riversnails/narsha_database/study/arm/MangoM32F2-Manual-Source/Mango-M32F2-프리미엄패키지1.jpg

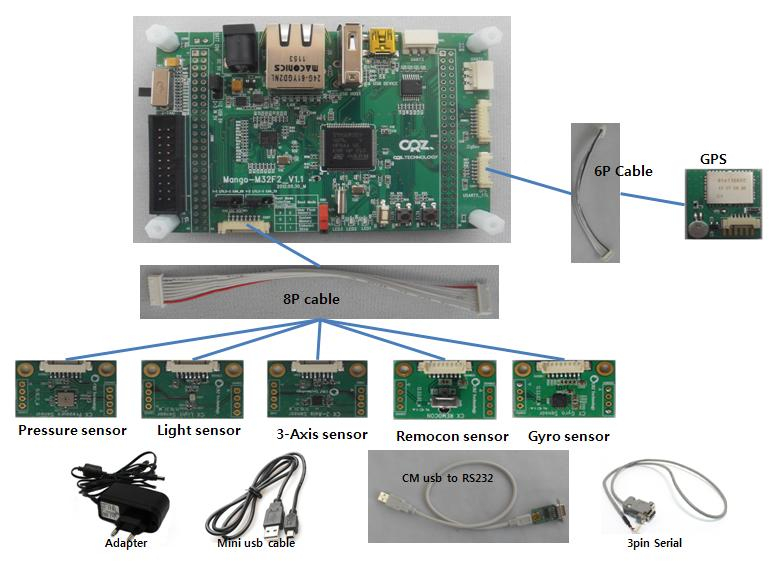
study/arm/MangoM32F2-Manual-Source/Mango-M32F2-프리미엄패키지1.jpg
