riversnails/narsha_database/readme.md

나르샤 저장용도의 리포지토리 입니다.
====================================
대구소프트웨어고등학교의 수업, 나르샤등의 자료를 저장하는 용도입니다.
