riversnails/narsha_database/study/arm/lecture/TIMER_PWM/LED_Servo_PWM.txt

[서보모터]
주기 : 20 ms
단계 : 2000 단계 

==> PSC : 720 -> 100 KHz
==> ARR : 2000 -> 20 ms

duty : 0.7 ~ 2.3 ms ==>  70 ~ 230 -> 160 단계
==> ARR : 70 ~ 230

[LED PWM]

주기 : 2 ms
단계 : 200 단계

==> PSC : 720 -> 100 KHz
==> ARR : 200 -> 2 ms
