riversnails/narsha_database/datasheet/1200px-Arduinomega1-4connectors.png

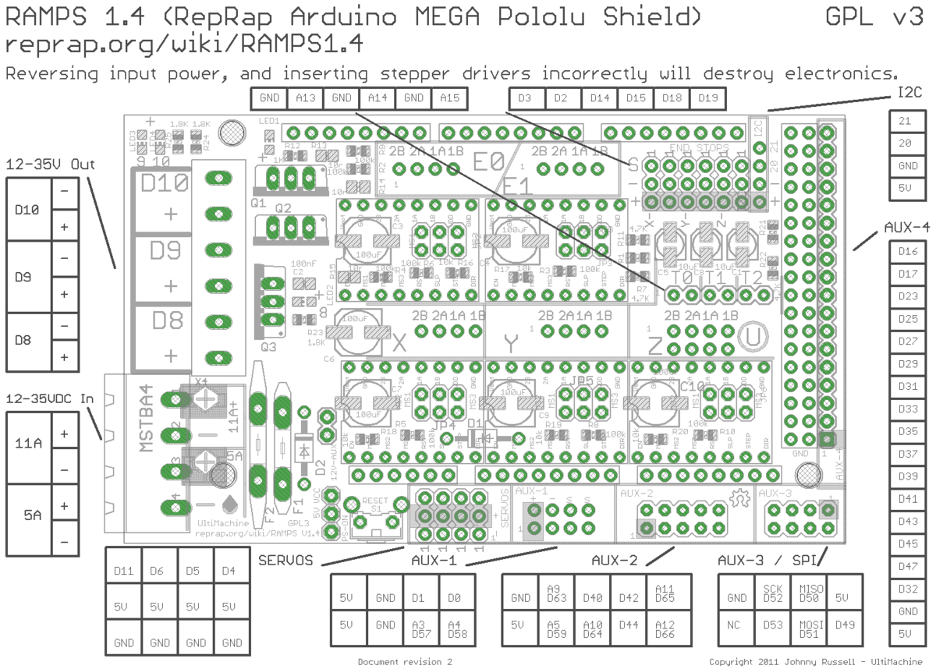
datasheet/1200px-Arduinomega1-4connectors.png
