riversnails/narsha_database/datasheet/1200px-Ramps_v1.4_shield_bothsides.png

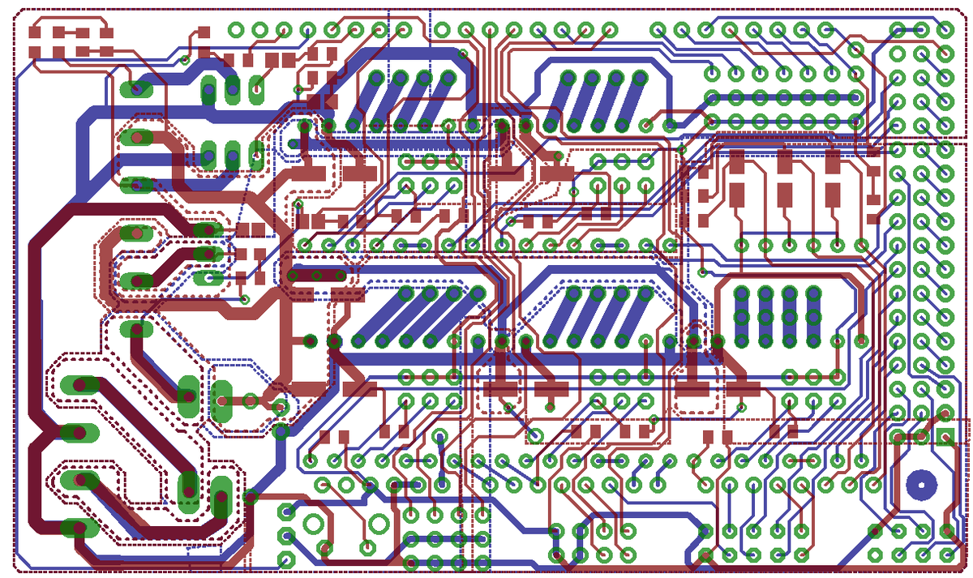
datasheet/1200px-Ramps_v1.4_shield_bothsides.png
