riversnails/narsha_database/datasheet/char_LCD_datasheet.png

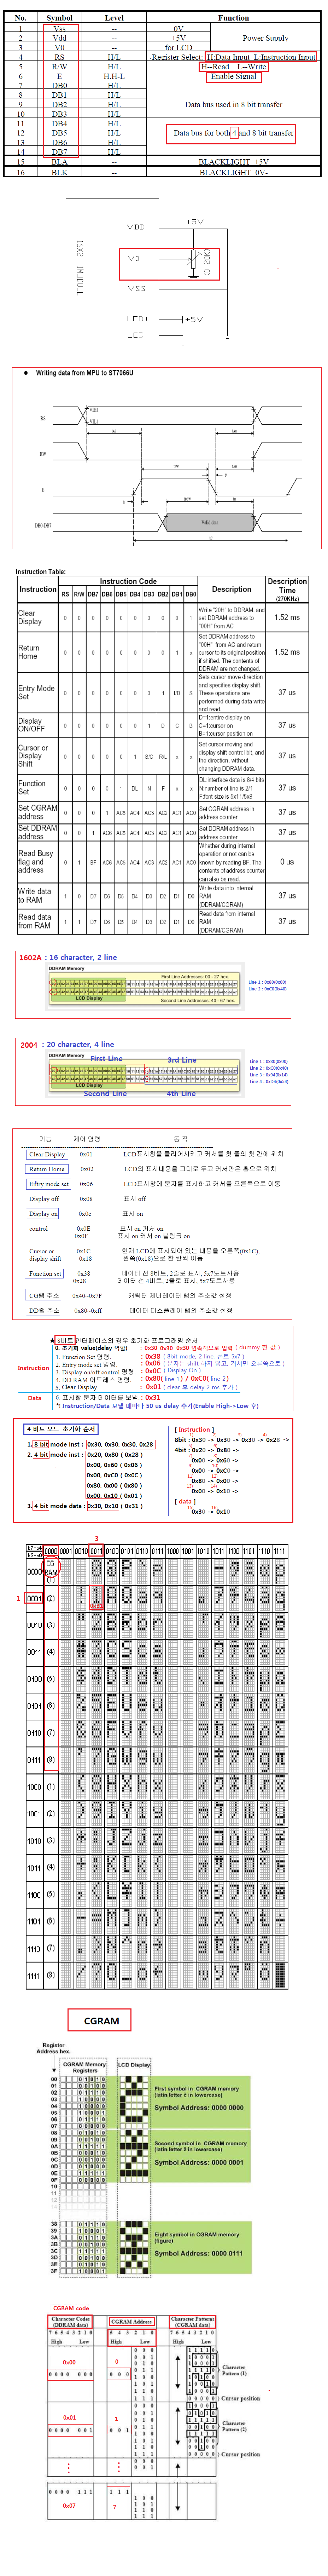
datasheet/char_LCD_datasheet.png
