riversnails/narsha_database/datasheet/dot matrix_datasheet.jpg

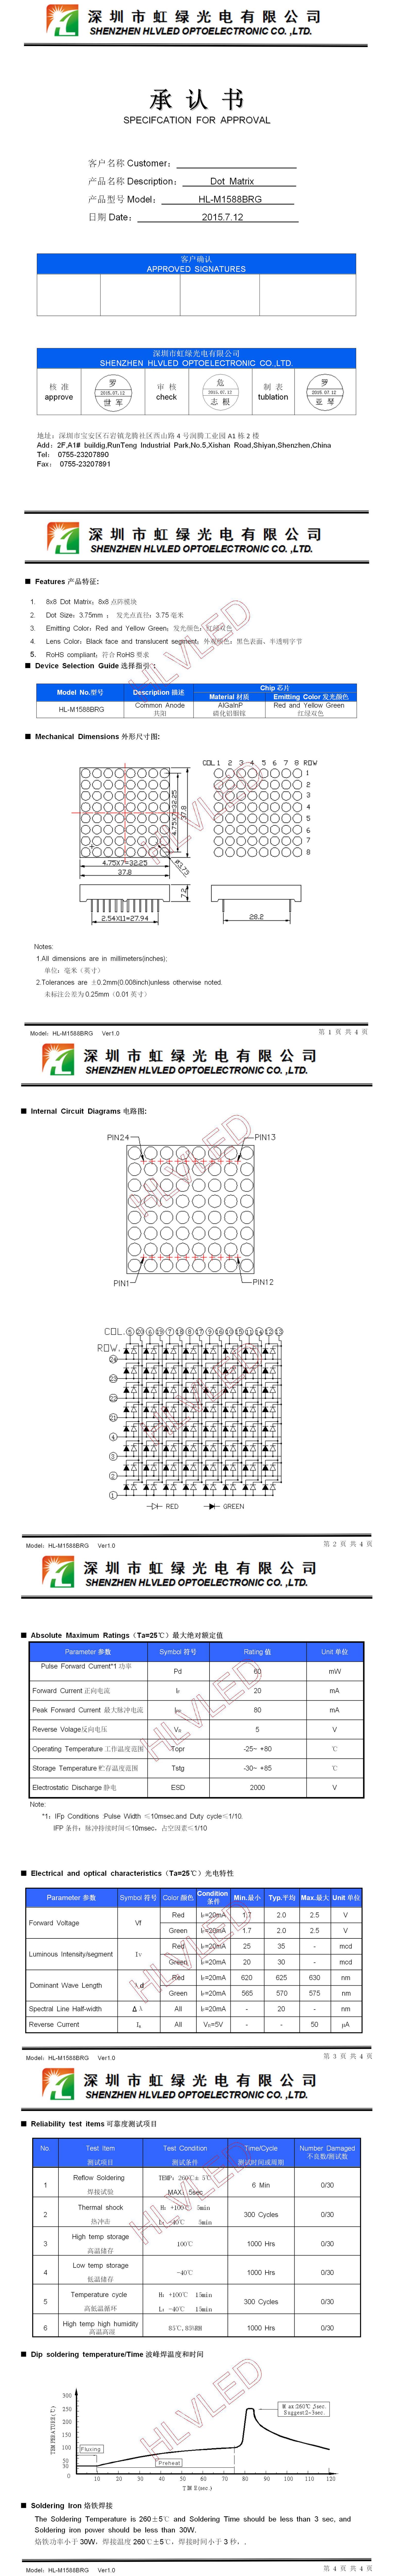
datasheet/dot matrix_datasheet.jpg
