riversnails/narsha_database/datasheet/nucleo_103RB/nucleo-103RB_pinMap.jpg

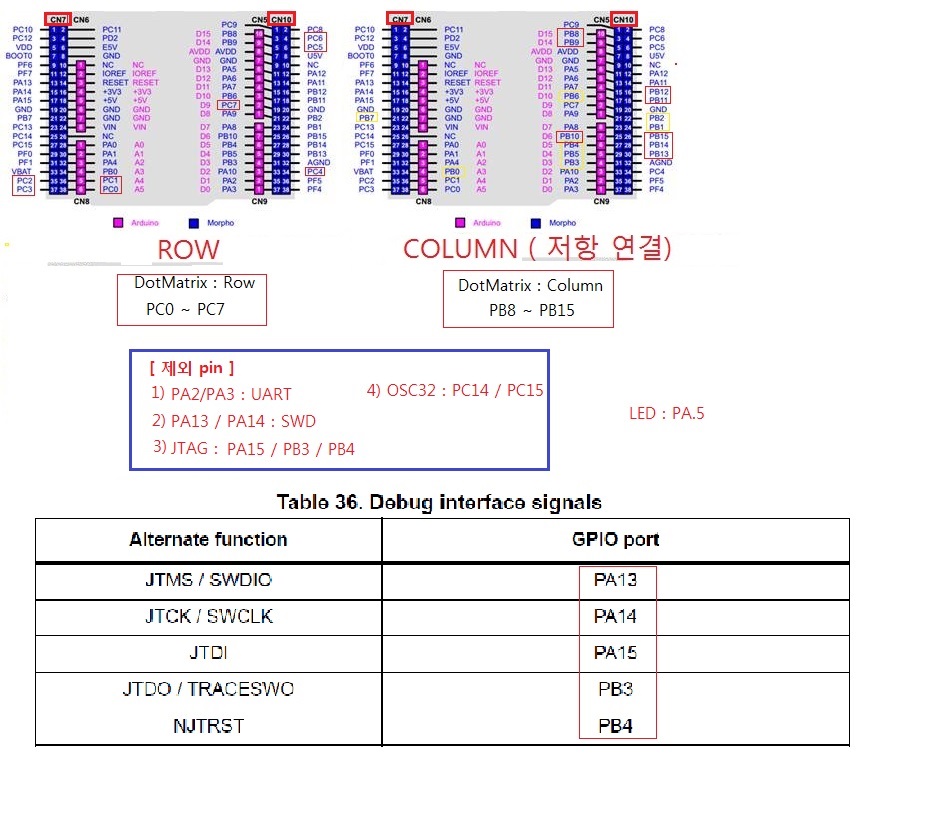
datasheet/nucleo_103RB/nucleo-103RB_pinMap.jpg
