riversnails/narsha_database/study/arm/GPIO/GPIO.png

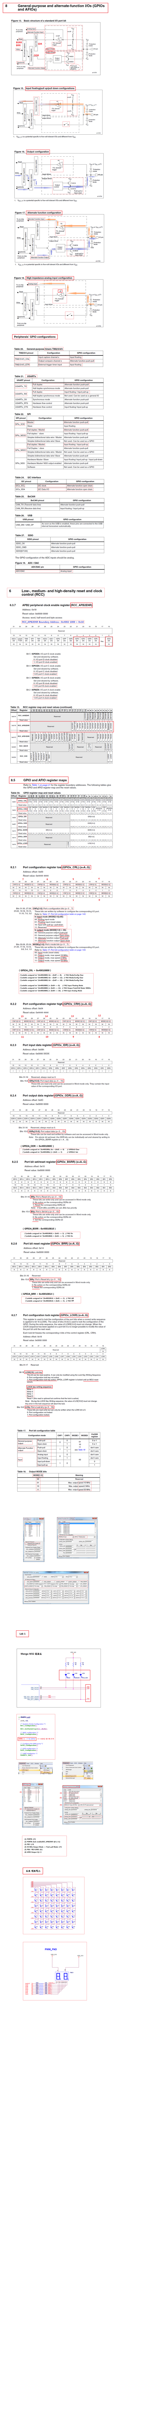
study/arm/GPIO/GPIO.png
