riversnails/narsha_database/study/arm/GPIO/도트매트릭스.png

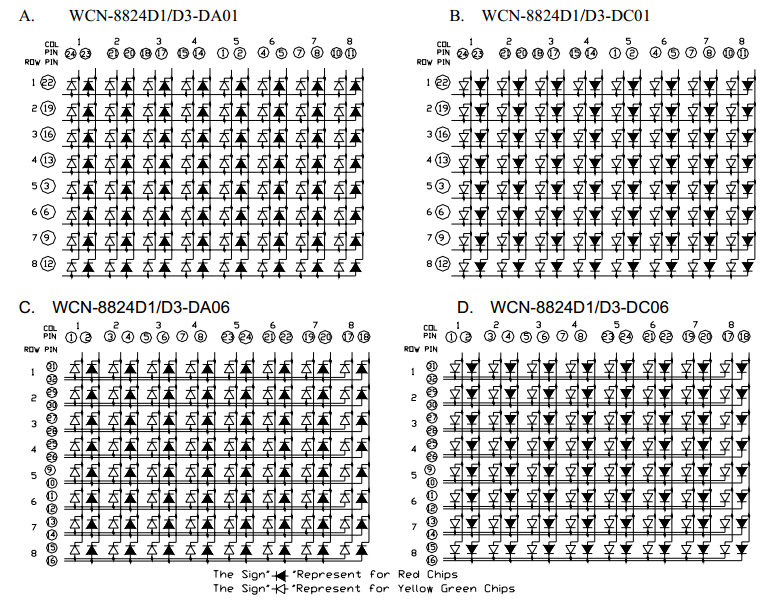
study/arm/GPIO/도트매트릭스.png
