riversnails/narsha_database/study/arm/lecture/ADC/ADC.png

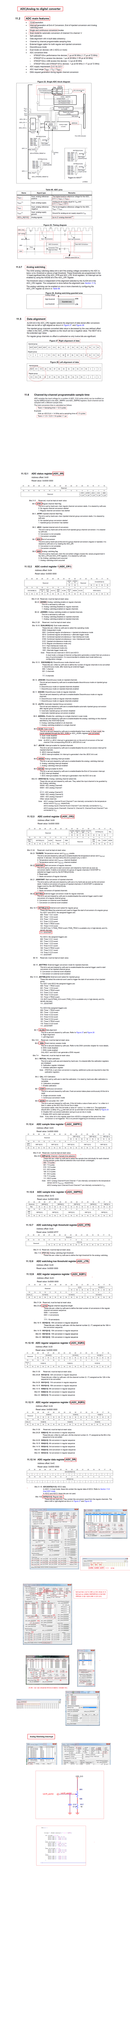
study/arm/lecture/ADC/ADC.png
