riversnails/narsha_database/study/arm/lecture/DMA/DMA.png

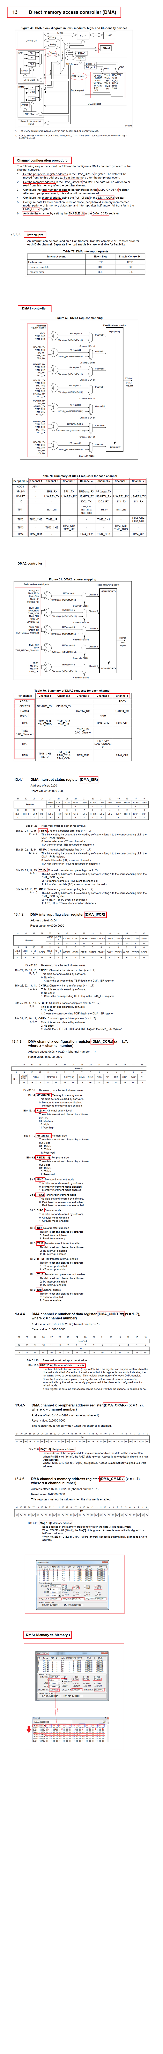
study/arm/lecture/DMA/DMA.png
