riversnails/narsha_database/study/arm/lecture/DMA/시험문제1.png

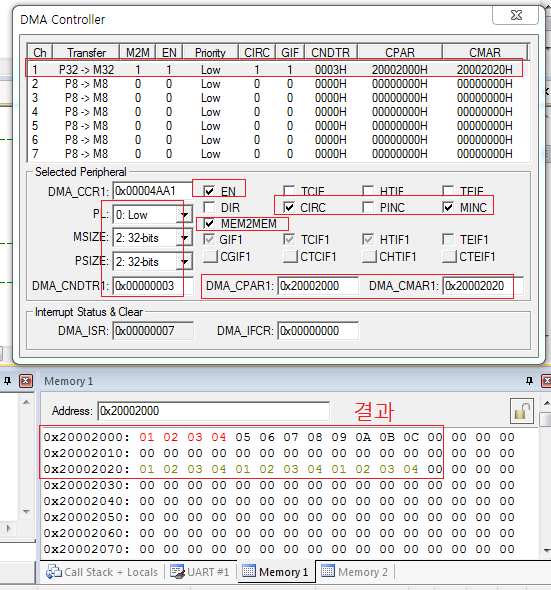
study/arm/lecture/DMA/시험문제1.png
