riversnails/narsha_database/study/arm/lecture/EXTI/4x4keypad.png

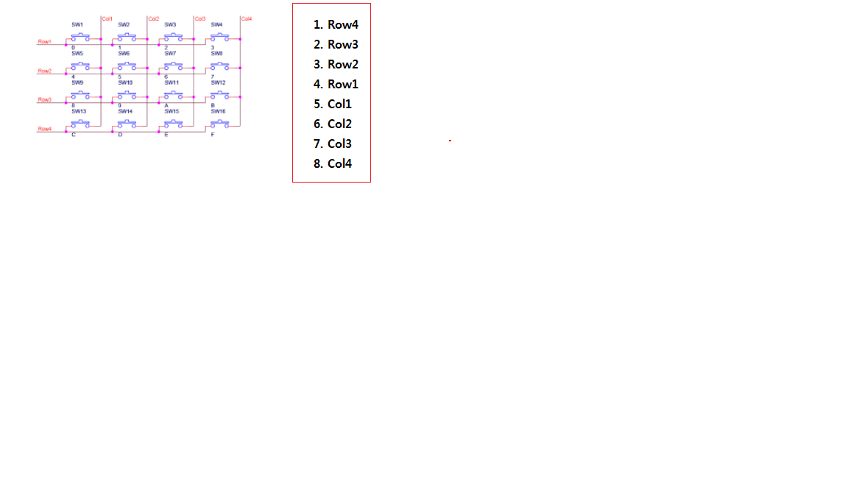
study/arm/lecture/EXTI/4x4keypad.png
