riversnails/narsha_database/study/arm/lecture/EXTI/EXTI.png

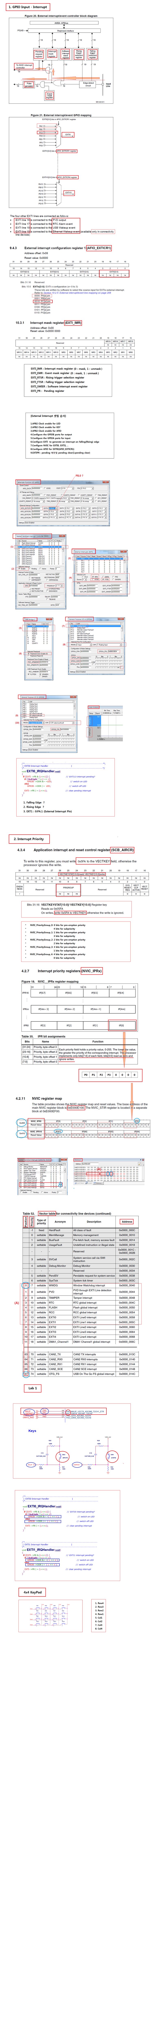
study/arm/lecture/EXTI/EXTI.png
