riversnails/narsha_database/study/arm/lecture/I2C/EEPROM_Read_Write.png

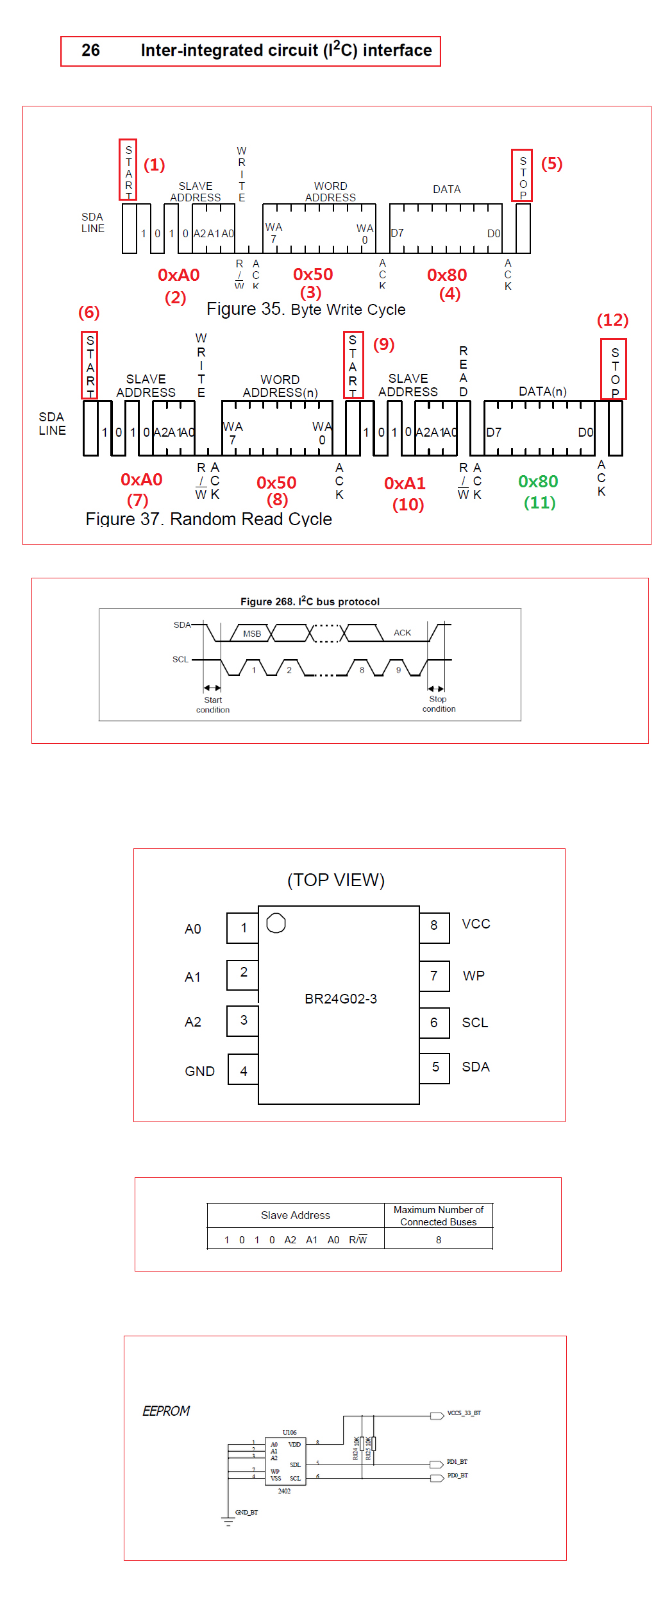
study/arm/lecture/I2C/EEPROM_Read_Write.png
