riversnails/narsha_database/study/arm/lecture/I2C/I2C.png

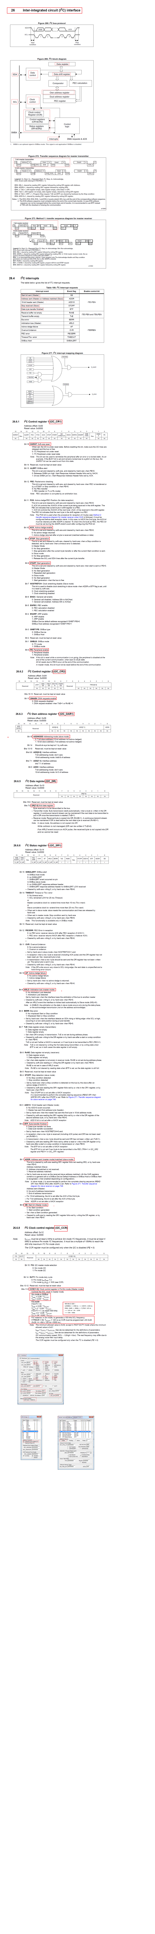
study/arm/lecture/I2C/I2C.png
