riversnails/narsha_database/study/arm/lecture/IWDG/IWDG.png

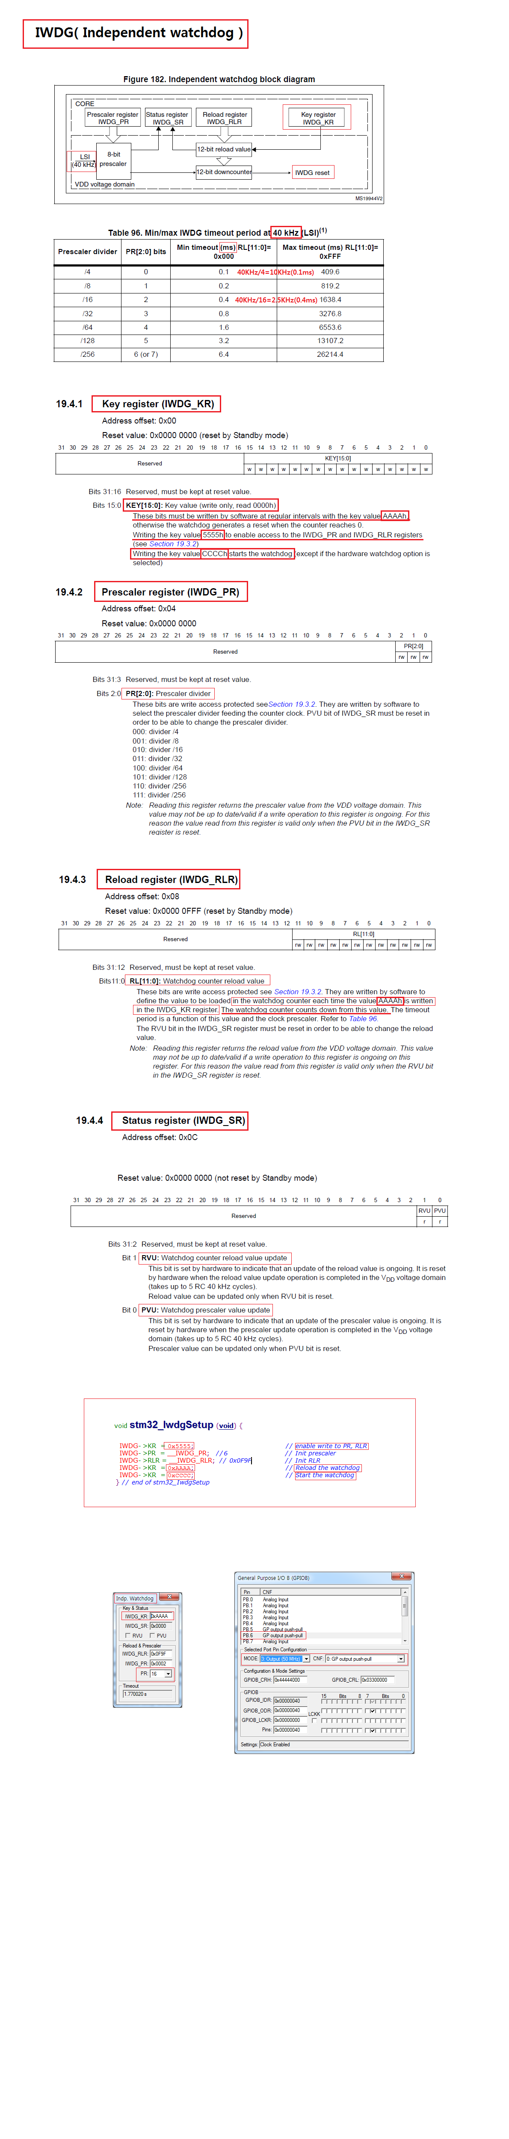
study/arm/lecture/IWDG/IWDG.png
