riversnails/narsha_database/study/arm/lecture/JTAG/jtag_pin.png

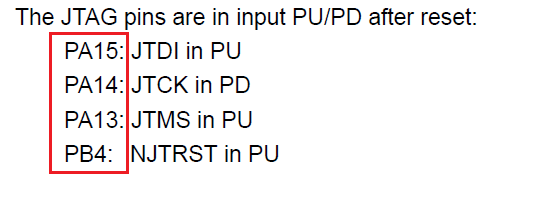
study/arm/lecture/JTAG/jtag_pin.png
