riversnails/narsha_database/study/arm/lecture/Keil_tool/keil_lib.png

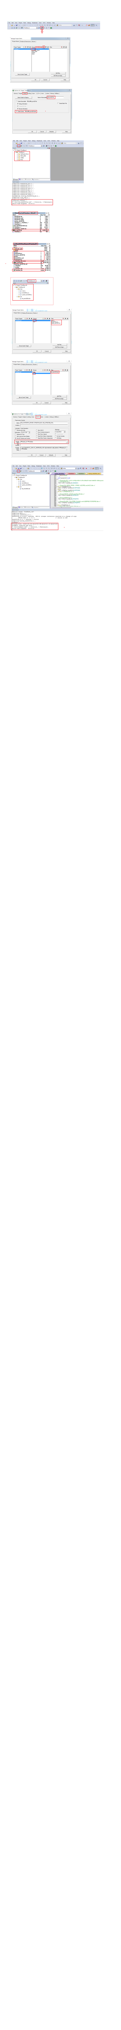
study/arm/lecture/Keil_tool/keil_lib.png
