riversnails/narsha_database/study/arm/lecture/Keil_tool/keil_new_project.png

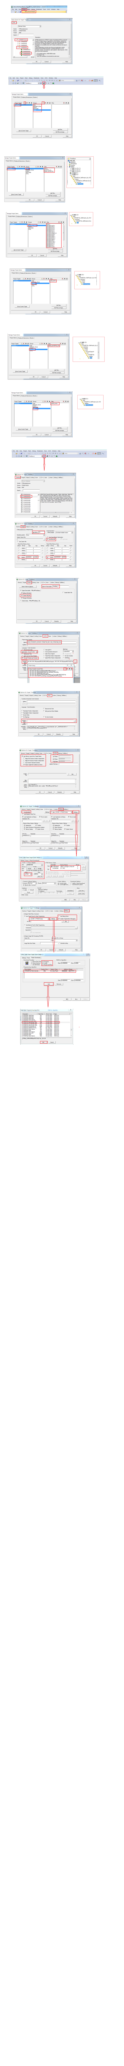
study/arm/lecture/Keil_tool/keil_new_project.png
