riversnails/narsha_database/study/arm/lecture/SPI/SPI.png

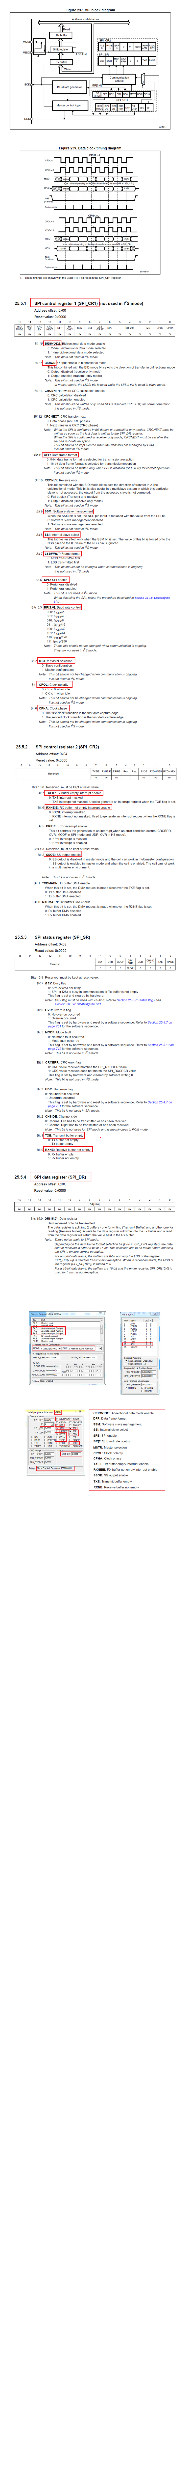
study/arm/lecture/SPI/SPI.png
