riversnails/narsha_database/study/arm/lecture/STM32_CortexM3/STM32_CortexM3.png

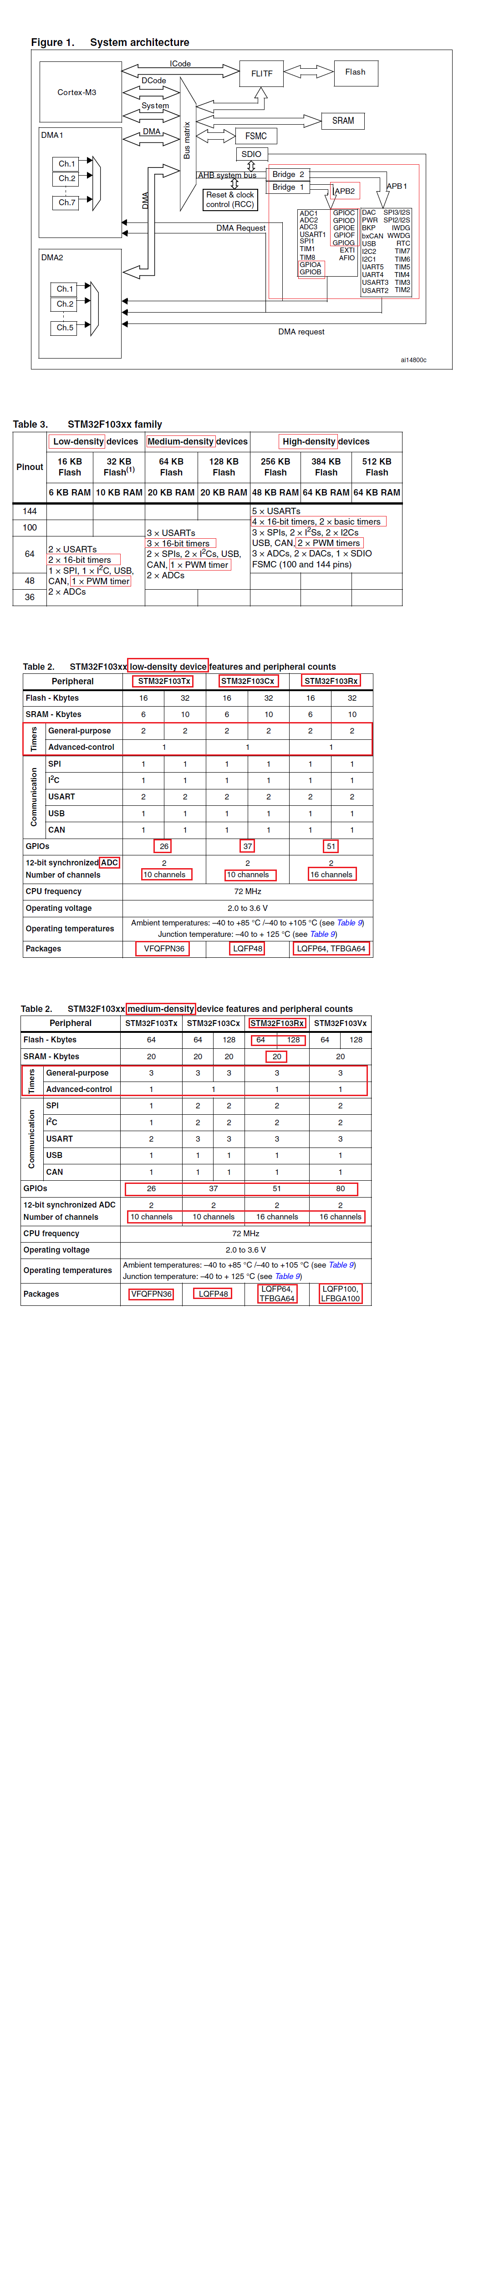
study/arm/lecture/STM32_CortexM3/STM32_CortexM3.png
