riversnails/narsha_database/study/arm/lecture/SYSTICk/SysTick.png

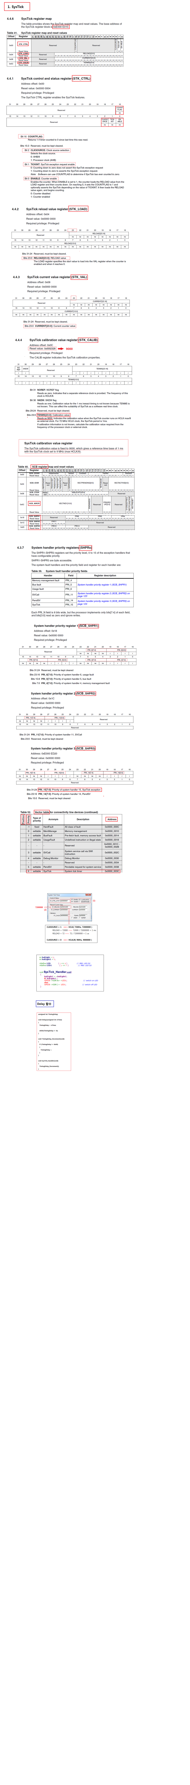
study/arm/lecture/SYSTICk/SysTick.png
