riversnails/narsha_database/study/arm/lecture/tft_lcd/LGDP4532.png

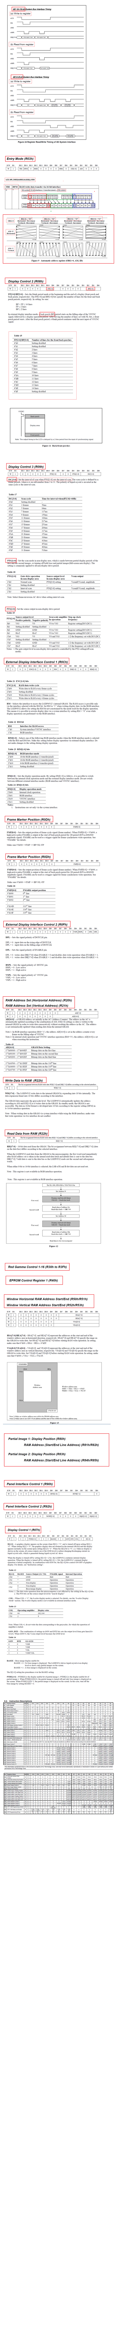
study/arm/lecture/tft_lcd/LGDP4532.png
