riversnails/narsha_database/study/arm/lecture/TIMER_PWM/TIMER_PWM.png

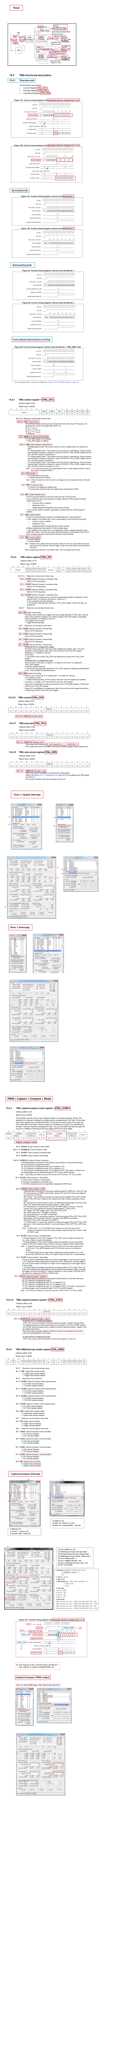
study/arm/lecture/TIMER_PWM/TIMER_PWM.png
