riversnails/narsha_database/study/arm/lecture/UART/CTS_RTS.png

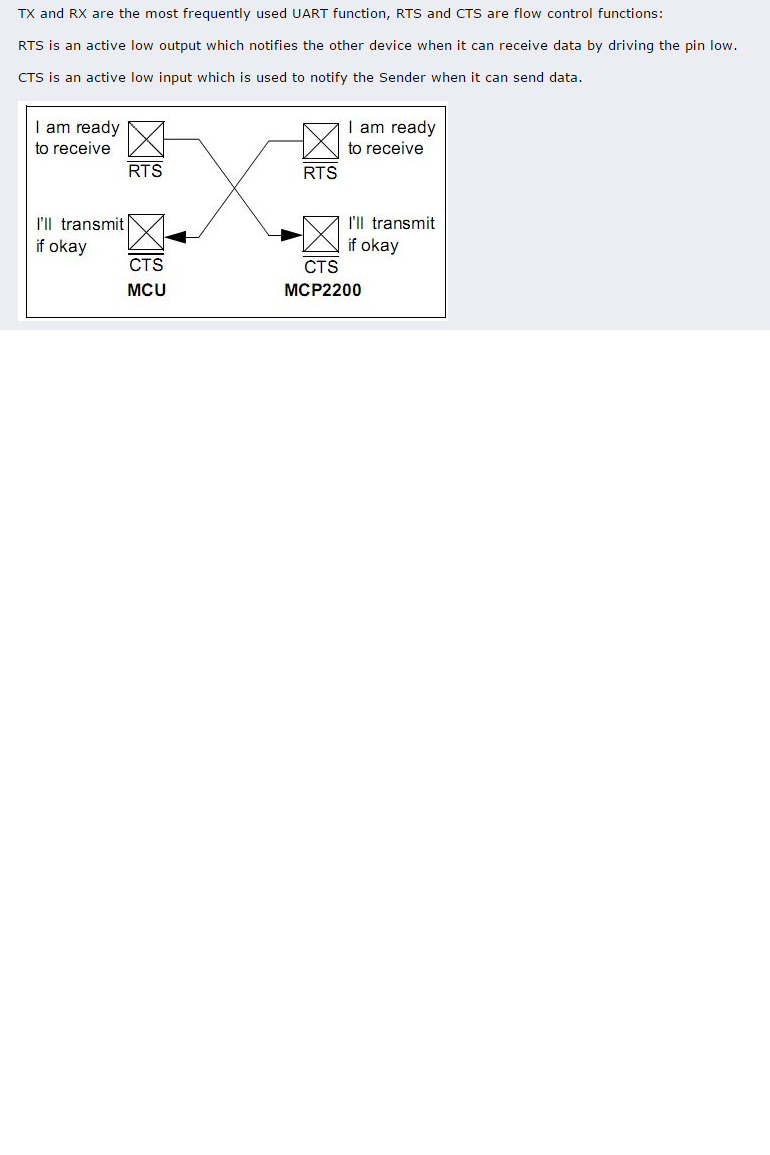
study/arm/lecture/UART/CTS_RTS.png
