riversnails/narsha_database/study/arm/lecture/UART/UART.png

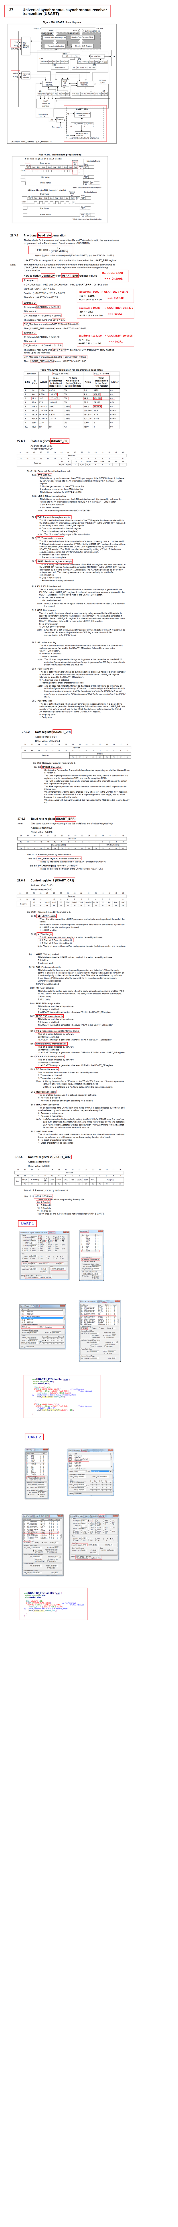
study/arm/lecture/UART/UART.png
