riversnails/narsha_database/study/avr/arduino/control2/main.png

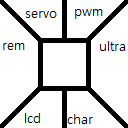
study/avr/arduino/control2/main.png
