riversnails/narsha_database/study/avr/arduino/control/main.bmp

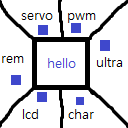
study/avr/arduino/control/main.bmp
