riversnails/narsha_database/study/avr/arduino/oled_128_128/tiger_128_128_24bit.bmp

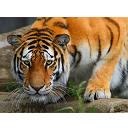
study/avr/arduino/oled_128_128/tiger_128_128_24bit.bmp
