riversnails/narsha_database/study/pads/uno headersize_2.png

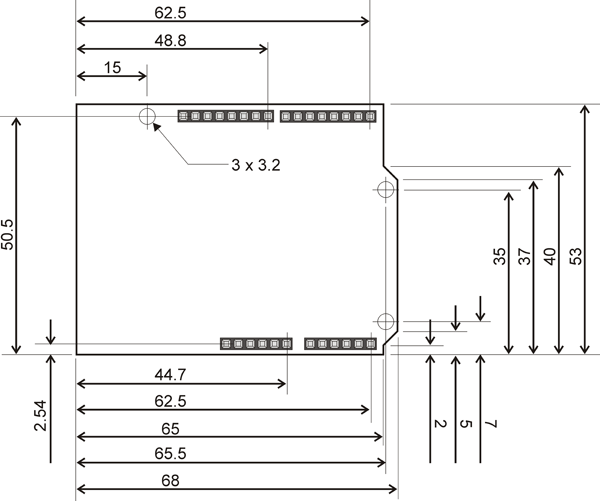
study/pads/uno headersize_2.png
