riversnails/narsha_database/study/tetris/background1.jpg

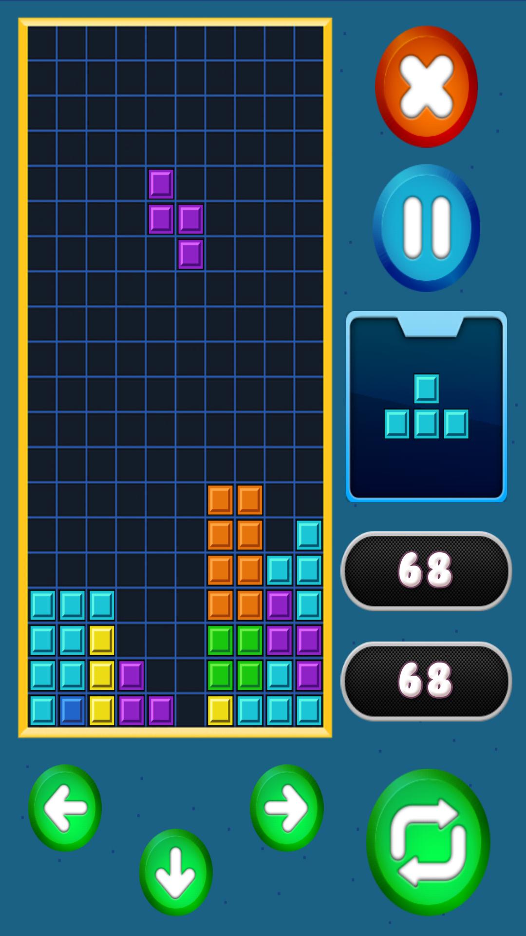
study/tetris/background1.jpg
