riversnails/narsha_database/study/tetris/background.jpg

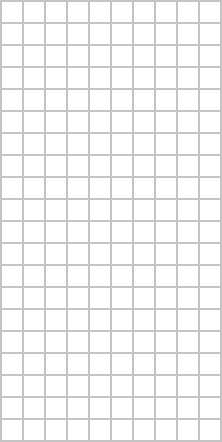
study/tetris/background.jpg
