riversnails/narsha_database/나르샤/tetris_re/tetris_re/Resources/tetris_background.png

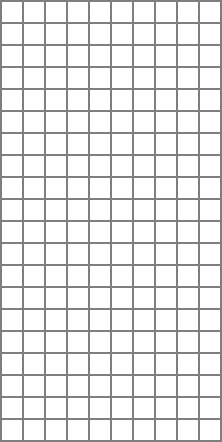
나르샤/tetris_re/tetris_re/Resources/tetris_background.png
