riversnails/narsha_database/study/arm/MangoM32F2-Manual-Source/Source/mango-m32f2_120612_1731_usbdev-vcp/src/readme.txt

/**
  @page USART_Printf USART_Printf
  
  @verbatim
  ******************** (C) COPYRIGHT 2011 STMicroelectronics *******************
  * @file    USART/USART_Printf/readme.txt 
  * @author  MCD Application Team
  * @version V1.0.0
  * @date    18-April-2011
  * @brief   Description of the USART Printf Example.
  ******************************************************************************
  * THE PRESENT FIRMWARE WHICH IS FOR GUIDANCE ONLY AIMS AT PROVIDING CUSTOMERS
  * WITH CODING INFORMATION REGARDING THEIR PRODUCTS IN ORDER FOR THEM TO SAVE
  * TIME. AS A RESULT, STMICROELECTRONICS SHALL NOT BE HELD LIABLE FOR ANY
  * DIRECT, INDIRECT OR CONSEQUENTIAL DAMAGES WITH RESPECT TO ANY CLAIMS ARISING
  * FROM THE CONTENT OF SUCH FIRMWARE AND/OR THE USE MADE BY CUSTOMERS OF THE
  * CODING INFORMATION CONTAINED HEREIN IN CONNECTION WITH THEIR PRODUCTS.
  ******************************************************************************
   @endverbatim

@par Example Description 

This example shows how to retarget the C library printf function to the USART. 
This implementation output the printf message on the Hyperterminal using USART3.

The USARTx is configured as follow:
    - BaudRate = 115200 baud  
    - Word Length = 8 Bits
    - One Stop Bit
    - No parity
    - Hardware flow control disabled (RTS and CTS signals)
    - Receive and transmit enabled

@par Directory contents 

  - USART/USART_Printf/system_stm32f2xx.c   STM32F2xx system clock configuration file
  - USART/USART_Printf/stm32f2xx_conf.h     Library Configuration file
  - USART/USART_Printf/stm32f2xx_it.h       Interrupt handlers header file
  - USART/USART_Printf/stm32f2xx_it.c       Interrupt handlers
  - USART/USART_Printf/main.c               Main program

@note The "system_stm32f2xx.c" is generated by an automatic clock configuration 
      tool and can be easily customized to your own configuration. 
      To select different clock setup, use the "STM32F2xx_Clock_Configuration_V1.0.0.xls" tool. 

@par Hardware and Software environment 

  - This example runs on STM32F2xx Devices.
  
  - This example has been tested with STM322xG-EVAL RevB and can be easily tailored
    to any other development board.

  - STM322xG-EVAL Set-up 
    - Connect a null-modem female/female RS232 cable between the DB9 connector 
      CN16 (USART3) and PC serial port if you want to display data on the HyperTerminal.
      @note Make sure that jumper JP22 is in position 1-2
 
  - Hyperterminal configuration:
    - Word Length = 8 Bits
    - One Stop Bit
    - No parity
    - BaudRate = 115200 baud
    - flow control: None 

@par How to use it ? 

In order to make the program work, you must do the following :
 - Copy all source files from this example folder to the template folder under
   Project\STM32F2xx_StdPeriph_Template
 - Open your preferred toolchain 
 - Rebuild all files and load your image into target memory
 - Run the example
  
 * <h3><center>&copy; COPYRIGHT 2011 STMicroelectronics</center></h3>
 */
