riversnails/narsha_database/study/arm/MangoM32F2-Manual-Source/Source/mango-m32f2_120612_1731_usbdev-vcp/project/EWARM-Standalone-httpserver/readme.txt

/**
  @page ewarm EWARM Project Template for STM32F2xx devices
  
  @verbatim
  ******************* (C) COPYRIGHT 2011 STMicroelectronics ********************
  * @file    readme.txt
  * @author  MCD Application Team
  * @version V1.0.0
  * @date    18-April-2011
  * @brief   This sub-directory contains all the user-modifiable files needed to
  *          create a new project linked with the STM32F2xx Standard Peripherals 
  *          Library and working with IAR Embedded Workbench for ARM (EWARM)
  *          software toolchain (version 6.10.5 and later).
  ******************************************************************************
  * THE PRESENT FIRMWARE WHICH IS FOR GUIDANCE ONLY AIMS AT PROVIDING CUSTOMERS
  * WITH CODING INFORMATION REGARDING THEIR PRODUCTS IN ORDER FOR THEM TO SAVE
  * TIME. AS A RESULT, STMICROELECTRONICS SHALL NOT BE HELD LIABLE FOR ANY
  * DIRECT, INDIRECT OR CONSEQUENTIAL DAMAGES WITH RESPECT TO ANY CLAIMS ARISING
  * FROM THE CONTENT OF SUCH FIRMWARE AND/OR THE USE MADE BY CUSTOMERS OF THE
  * CODING INFORMATION CONTAINED HEREIN IN CONNECTION WITH THEIR PRODUCTS.
  ******************************************************************************
  @endverbatim
 
 @par Directory contents

 - project .ewd/.eww/.ewp: A pre-configured project file with the provided library 
                           structure that produces an executable image with IAR 
                           Embedded Workbench.
                
 - stm32f2xx_flash.icf : This file is the IAR Linker configuration file used to 
                         place program code (readonly) in internal FLASH and data
                         (readwrite, Stack and Heap)in internal SRAM. 
                         You can customize this file to your need.                                                                                

 - stm32f2xx_flash_extsram.icf: This file is the IAR Linker configuration file 
                                used to place program code (readonly) in internal 
                                FLASH and data (readwrite, Stack and Heap)in 
                                external SRAM. You can customize this file to your need.  
                                
 - stm32f2xx_ram.icf:  This file is the IAR Linker configuration file used to 
                       place program code (readonly) and data (readwrite, Stack 
                       and Heap)in internal SRAM. 
                       You can customize this file to your need.                    
                             
 @par How to use it ?

 - Open the Project.eww workspace.
 - Rebuild all files: Project->Rebuild all
 - Load project image: Project->Download and Debug
 - Run program: Debug->Go(F5)

 @note The needed define symbols for this config are already declared in the
       preprocessor section: USE_STM322xG_EVAL, STM32F2XX, USE_STDPERIPH_DRIVER 

 * <h3><center>&copy; COPYRIGHT 2011 STMicroelectronics</center></h3>
 */
