riversnails/narsha_database/study/arm/STM32F2xx_StdPeriph_Lib_V1.1.0/Project/STM32F2xx_StdPeriph_Examples/TIM/6Steps/readme.txt

/**
  @page TIM_6Steps TIM 6 Steps example
  
  @verbatim
  ******************** (C) COPYRIGHT 2012 STMicroelectronics *******************
  * @file    TIM/6Steps/readme.txt 
  * @author  MCD Application Team
  * @version V1.1.0
  * @date    13-April-2012
  * @brief   Description of the TIM 6 Steps example.
  ******************************************************************************
  *
  * Licensed under MCD-ST Liberty SW License Agreement V2, (the "License");
  * You may not use this file except in compliance with the License.
  * You may obtain a copy of the License at:
  *
  *        http://www.st.com/software_license_agreement_liberty_v2
  *
  * Unless required by applicable law or agreed to in writing, software 
  * distributed under the License is distributed on an "AS IS" BASIS, 
  * WITHOUT WARRANTIES OR CONDITIONS OF ANY KIND, either express or implied.
  * See the License for the specific language governing permissions and
  * limitations under the License.
  *
  ******************************************************************************
   @endverbatim

@par Example Description 

This example shows how to configure the TIM1 peripheral to generate 6 Steps.
The STM32F2xx TIM1 peripheral offers the possibility to program in advance the 
configuration for the next TIM1 outputs behaviour (step) and change the configuration
of all the channels at the same time. This operation is possible when the COM 
(commutation) event is used.
The COM event can be generated by software by setting the COM bit in the TIM1_EGR
register or by hardware (on TRC rising edge).
In this example, a software COM event is generated each 100 ms: using the SysTick 
interrupt.
The TIM1 is configured in Timing Mode, each time a COM event occurs, a new TIM1
configuration will be set in advance.

The break Polarity is used at High level.

The following Table describes the TIM1 Channels states:
 @verbatim
              -----------------------------------------------
             | Step1 | Step2 | Step3 | Step4 | Step5 | Step6 |
   ----------------------------------------------------------
  |Channel1  |   1   |   0   |   0   |   0   |   0   |   1   |
   ----------------------------------------------------------
  |Channel1N |   0   |   0   |   1   |   1   |   0   |   0   |
   ----------------------------------------------------------
  |Channel2  |   0   |   0   |   0   |   1   |   1   |   0   |
   ----------------------------------------------------------
  |Channel2N |   1   |   1   |   0   |   0   |   0   |   0   |
   ----------------------------------------------------------
  |Channel3  |   0   |   1   |   1   |   0   |   0   |   0   |
   ----------------------------------------------------------
  |Channel3N |   0   |   0   |   0   |   0   |   1   |   1   |
   ----------------------------------------------------------
 @endverbatim

@par Directory contents 

  - TIM/6Steps/stm32f2xx_conf.h    Library Configuration file
  - TIM/6Steps/stm32f2xx_it.c      Interrupt handlers
  - TIM/6Steps/stm32f2xx_it.h      Interrupt handlers header file
  - TIM/6Steps/main.c              Main program
  - TIM/6Steps/system_stm32f2xx.c  STM32F2xx system source file

@note The "system_stm32f2xx.c" is generated by an automatic clock configuration 
      tool and can be easily customized to your own configuration. 
      To select different clock setup, use the "STM32F2xx_Clock_Configuration_V1.0.0.xls" 
      provided with the AN3362 package available on <a href="http://www.st.com/internet/mcu/family/141.jsp">  ST Microcontrollers </a>

@par Hardware and Software environment 

  - This example runs on STM32F2xx Devices.
  
  - This example has been tested with STM322xG-EVAL RevB and can be easily tailored
    to any other development board.    

  - STM322xG Set-up 
    - Connect the TIM1 pins to an oscilloscope to monitor the different waveforms:
      - TIM1_CH3  pin (PA.10)
      - TIM1_CH1N pin (PB.13)  
      - TIM1_CH2  pin (PE.11)  
      - TIM1_CH3N pin (PB.15)
      - TIM1_CH1  pin (PA.08)  
      - TIM1_CH2N pin (PB.14)    
    - Connect the TIM1 break pin TIM1_BKIN pin (PB.12) to the GND. To generate a 
      break event, switch this pin level from 0V to 3.3V. 

@par How to use it ? 

In order to make the program work, you must do the following :
 - Copy all source files from this example folder to the template folder under
   Project\STM32F2xx_StdPeriph_Template
 - Open your preferred toolchain 
 - Rebuild all files and load your image into target memory
 - Run the example
   
 * <h3><center>&copy; COPYRIGHT STMicroelectronics</center></h3>
 */
