riversnails/narsha_database/study/arm/lecture/UART/uart_printf.txt

#ifdef __GNUC__
  /* With GCC/RAISONANCE, small printf (option LD Linker->Libraries->Small printf
     set to 'Yes') calls __io_putchar() */
  #define PUTCHAR_PROTOTYPE int __io_putchar(int ch)
#else
  #define PUTCHAR_PROTOTYPE int fputc(int ch, FILE *f)
#endif /* __GNUC__ */

	PUTCHAR_PROTOTYPE
{
	while(!(USART1->SR & (0x01 << 7)));
  USART1->DR = (unsigned char)ch;
	
  return ch;
}
