riversnails/narsha_database/study/arm/MangoM32F2-Manual-Source/Mango-M32F2-부품배치도.pptx

## Slide 2

Battery Connector

RJ-45 Connector

USB Host

USB Device

Power Select Switch

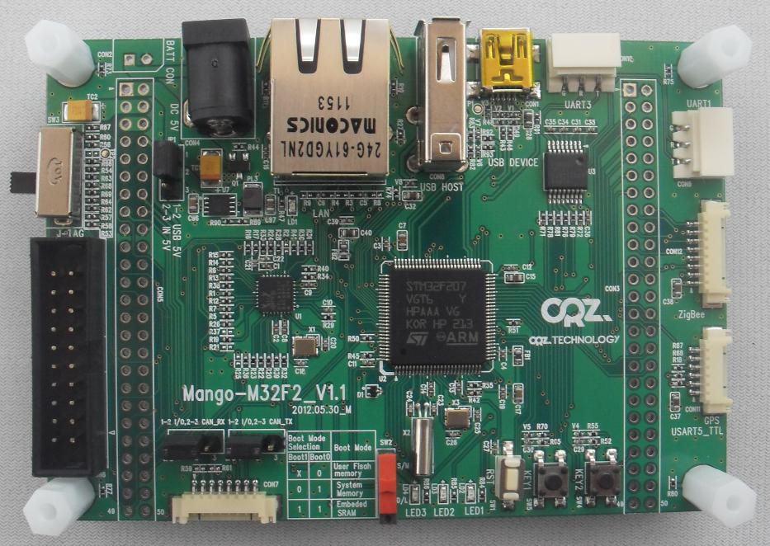
[picture p112: figure]

DC 5V Adapter

RS232 Port3

RS232 Port1(Debug)

Power ON/OFF

50P Expansion A

Zigbee 8P Connector

SP3232 Level Shift

Power LED

STM32F207VGT CPU

JTAG 20P

RTL8201CP 10/100Mbs Ethernet

UART5(GPS etc)

I2C/CAN
(Sensor Connector)

50P Expansion B

CAN/IO Select Switch1

Boot Switch

LED 1,2,3

Reset

KEY1

KEY2

CAN/IO Select Switch1
