riversnails/narsha_database/study/arm/MangoM32F2-Manual-Source/Mango-M32F2-센서연결도.pptx

## Slide 2

Zigbee


8P cable

GPS

6P Cable

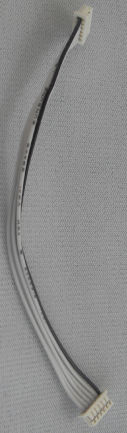
[picture p113: figure]
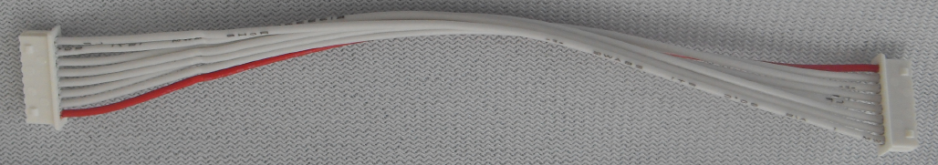
[picture p114: figure]

8P cable

Pressure sensor

Light sensor

3-Axis sensor

Remocon sensor

Gyro sensor

CAN Tranceiver
