riversnails/narsha_database/study/arm/MangoM32F2-Manual-Source/Mango-M32F2-PCBSize.jpg

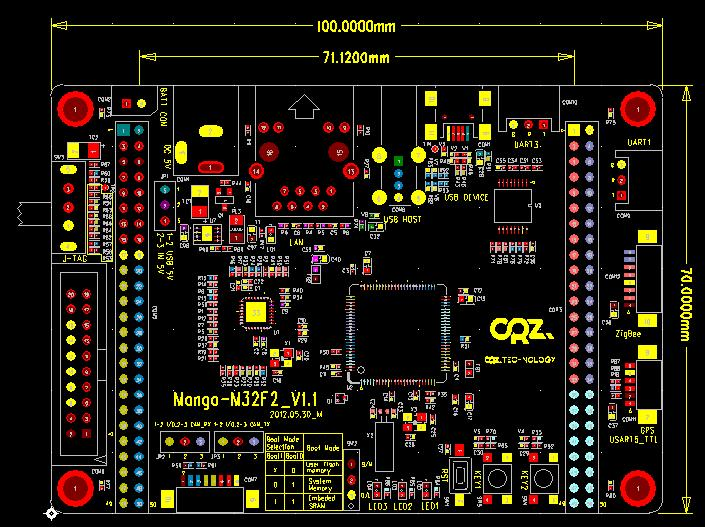
study/arm/MangoM32F2-Manual-Source/Mango-M32F2-PCBSize.jpg
