riversnails/narsha_database/study/arm/MangoM32F2-Manual-Source/Mango-M32F2-기본패키지1.jpg

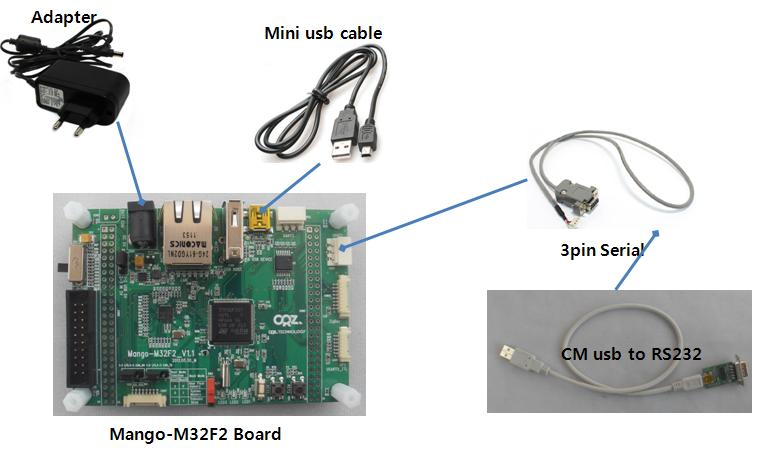
study/arm/MangoM32F2-Manual-Source/Mango-M32F2-기본패키지1.jpg
