riversnails/narsha_database/study/arm/MangoM32F2-Manual-Source/Mango-M32F2-배치도.jpg

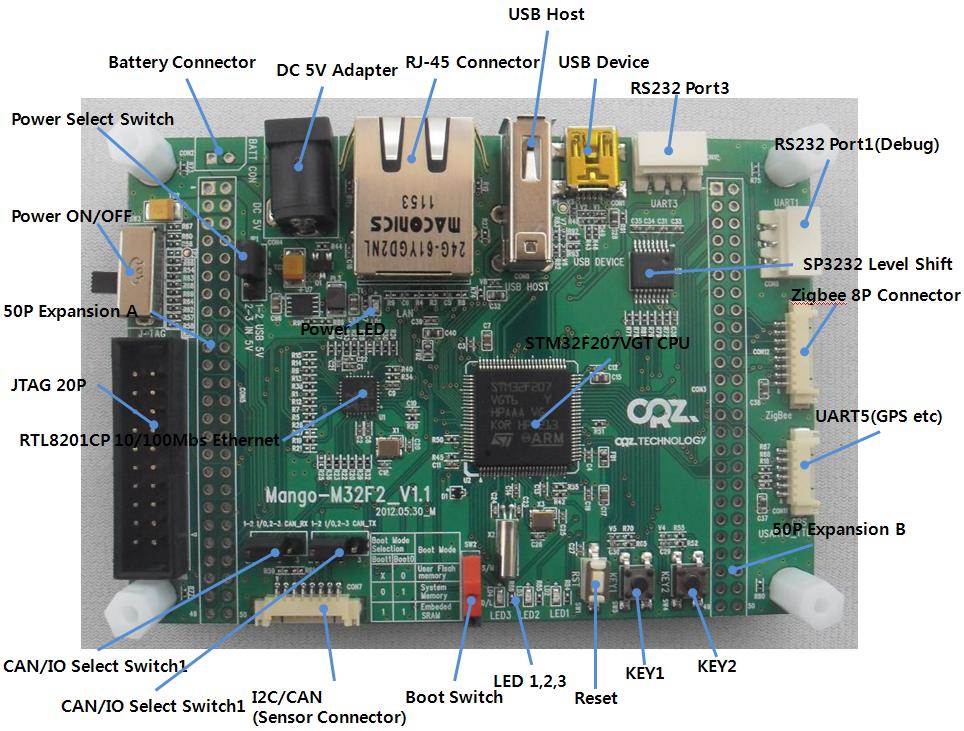
study/arm/MangoM32F2-Manual-Source/Mango-M32F2-배치도.jpg
