riversnails/narsha_database/study/arm/MangoM32F2-Manual-Source/08. (ARM,Cortex-M3, STM32F207) Mango-M32F2 - 1.01. Library Debug.docx

(ARM,Cortex-M3, STM32F207) Mango-M32F2 - 1.01. Library Debug | | | | | | ☞ 망고M32F2 메뉴얼 (http://cafe.naver.com/ArticleList.nhn?search.clubid=15961514&search.menuid=182&search.boardtype=L&userDisplay=)
| 2012.06.20 10:52 | | | 삭제

푸우(yhoh) (http://cafe.naver.com/ArticleRead.nhn?clubid=15961514&page=1&boardtype=L&articleid=19164) | 카페스탭

http://cafe.naver.com/embeddedcrazyboys/19164

첨부파일(1) (http://cafe.naver.com/ArticleRead.nhn?clubid=15961514&page=1&boardtype=L&articleid=19164)

오늘부터 망고스토리 3.0에서 다루었던 내용들을

Mango-M32F2에서하나씩 수행을 해보도록 하려고 합니다.

첫 시간으로 LibraryDebug 부분입니다.

Mango-M32F2_120612_1806_UsbHost-MSC.zip부분을 Base Program으로 해서

각각의 내용을 하나씩 살펴보도록 합니다.

STM32F2xx_StdPeriph_Lib_V1.0.0.original\Project\STM32F2xx_StdPeriph_Examples\Lib_DEBUG\Lib_DEBUG_Example

이 폴더에 예제가 들어 있고 이것을 적용하도록합니다.

적용 자체는 stm32f2xx_ip_dbg.c,stm32f2xx_ip_dbg.h를 복사하고

테스트 코드를 넣어준 것 뿐입니다.

Press menu key

0> System Information

1> Test LED

3> Test Lib_DEBUG

x> quit

3 is selected

3을누르면 동작하도록 구현해 놓았습니다.

STM32F2xx Firmware Library compiled with FULL ASSERT function...

...Run-time checking enabled

ERROR !! assert_failed - File:D:\Wk.Src\Mango-M32F2\Libraries\STM32F2xx_StdPeriph_Driver\src\stm32f2xx_rcc.c, Line:1206

위와 같이 문제가 되는 상황이 정확히 수행되고있습니다.

너무 간단한 내용이었네요 ^^
