riversnails/narsha_database/study/pads/SCHEMATIC1 _ 1_STM32F103.pdf

# DEBUG/Serial

# CHAR LCD

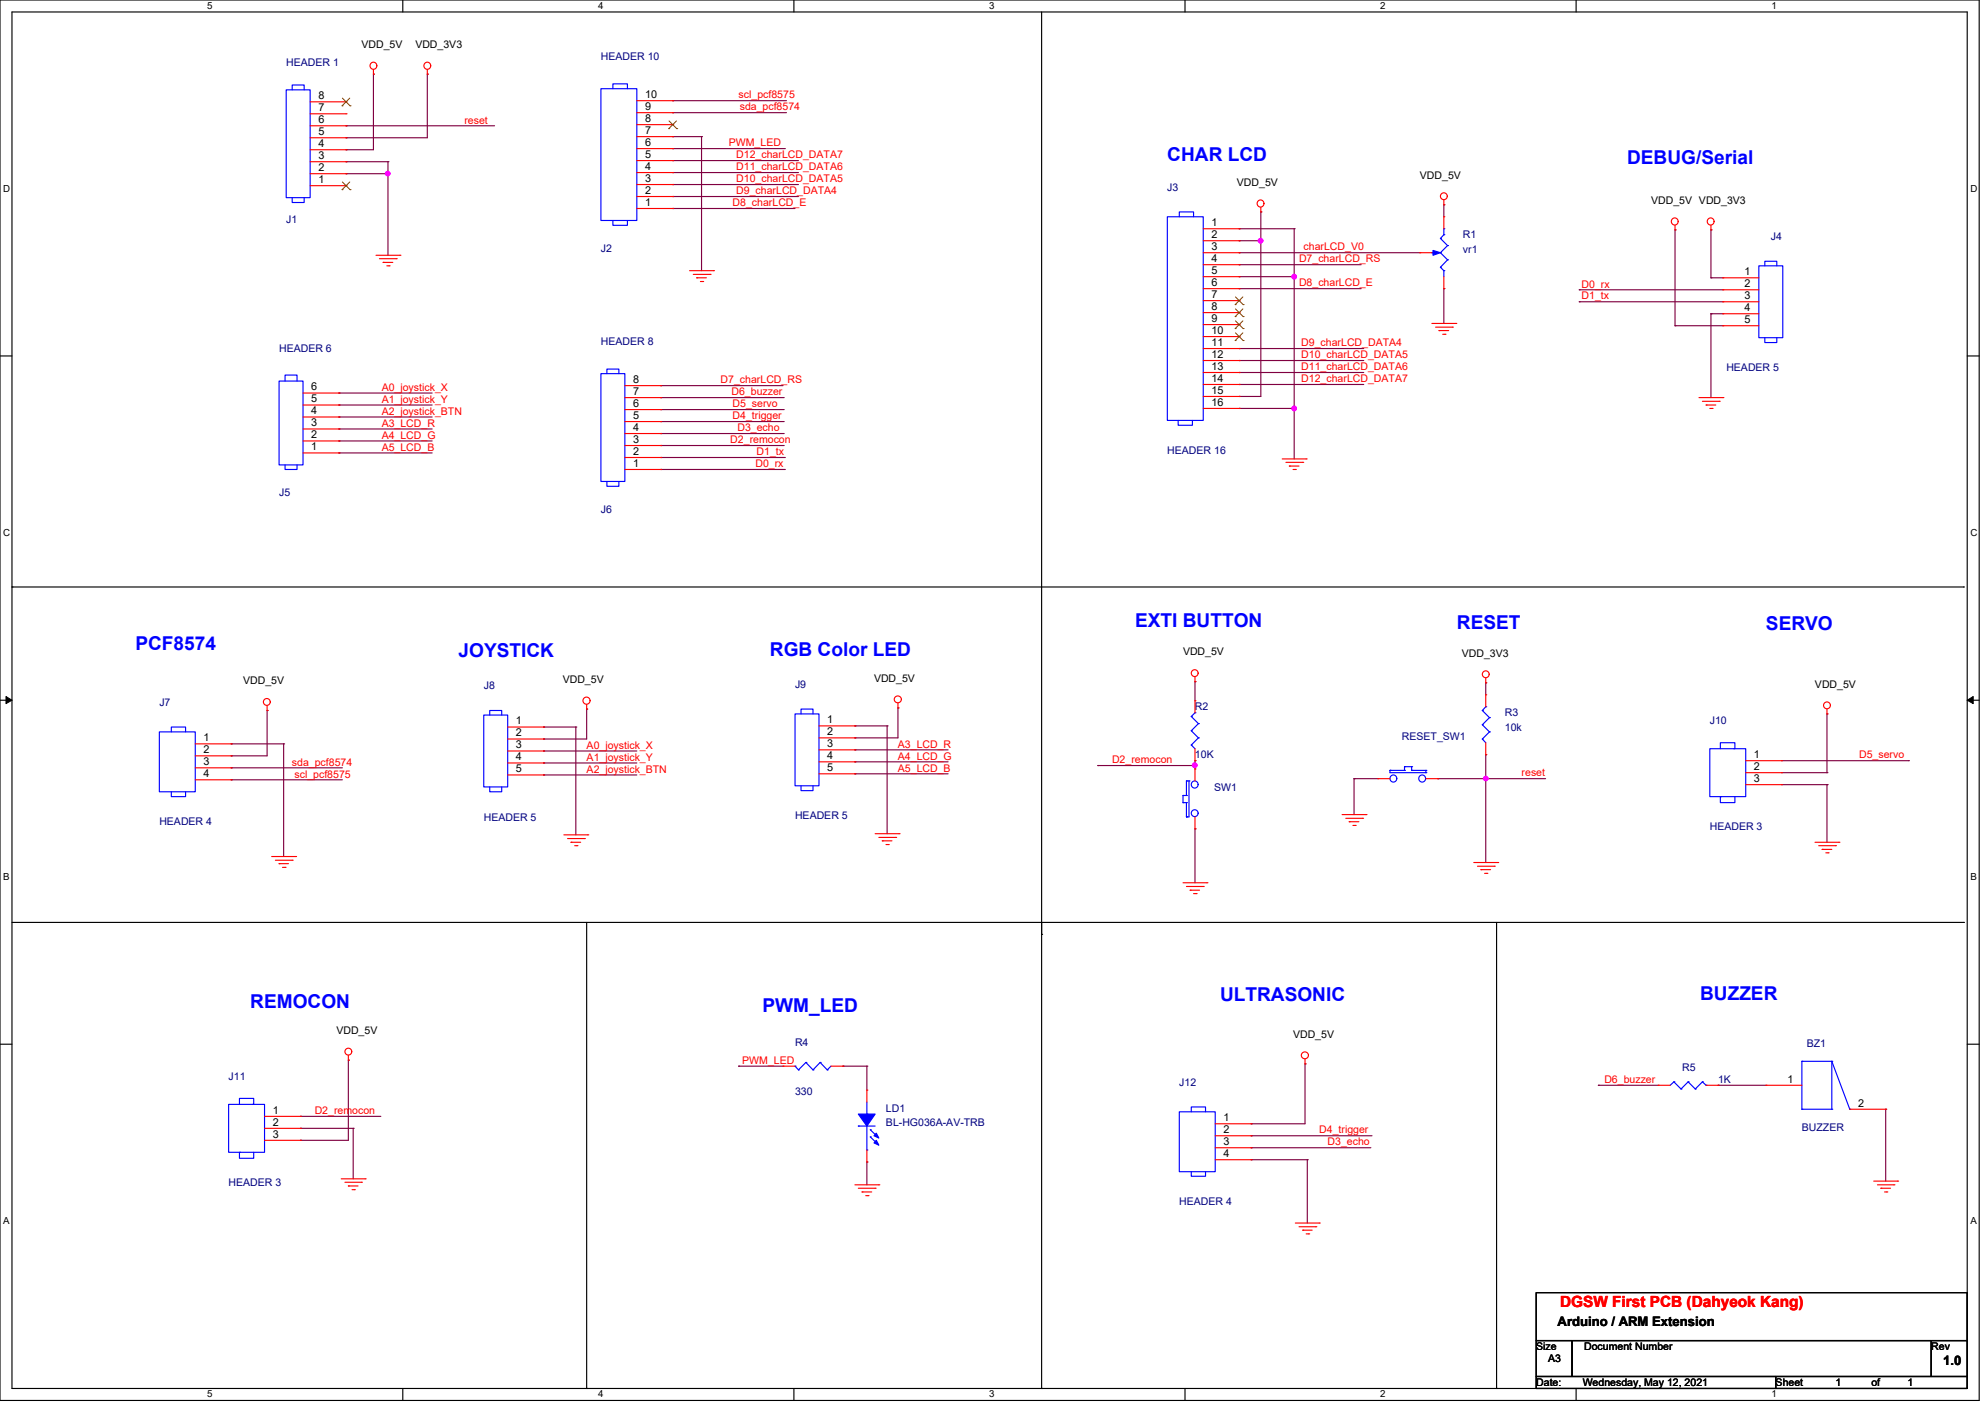
[picture p121: page 1]

DGSW First PCB (Dahyeok Kang) Arduino / ARM Extension
