riversnails/narsha_database/study/pads/04_UNO_LED_SERVO_PWM.pdf

5 | 4 | 3 | 2 | 1

D

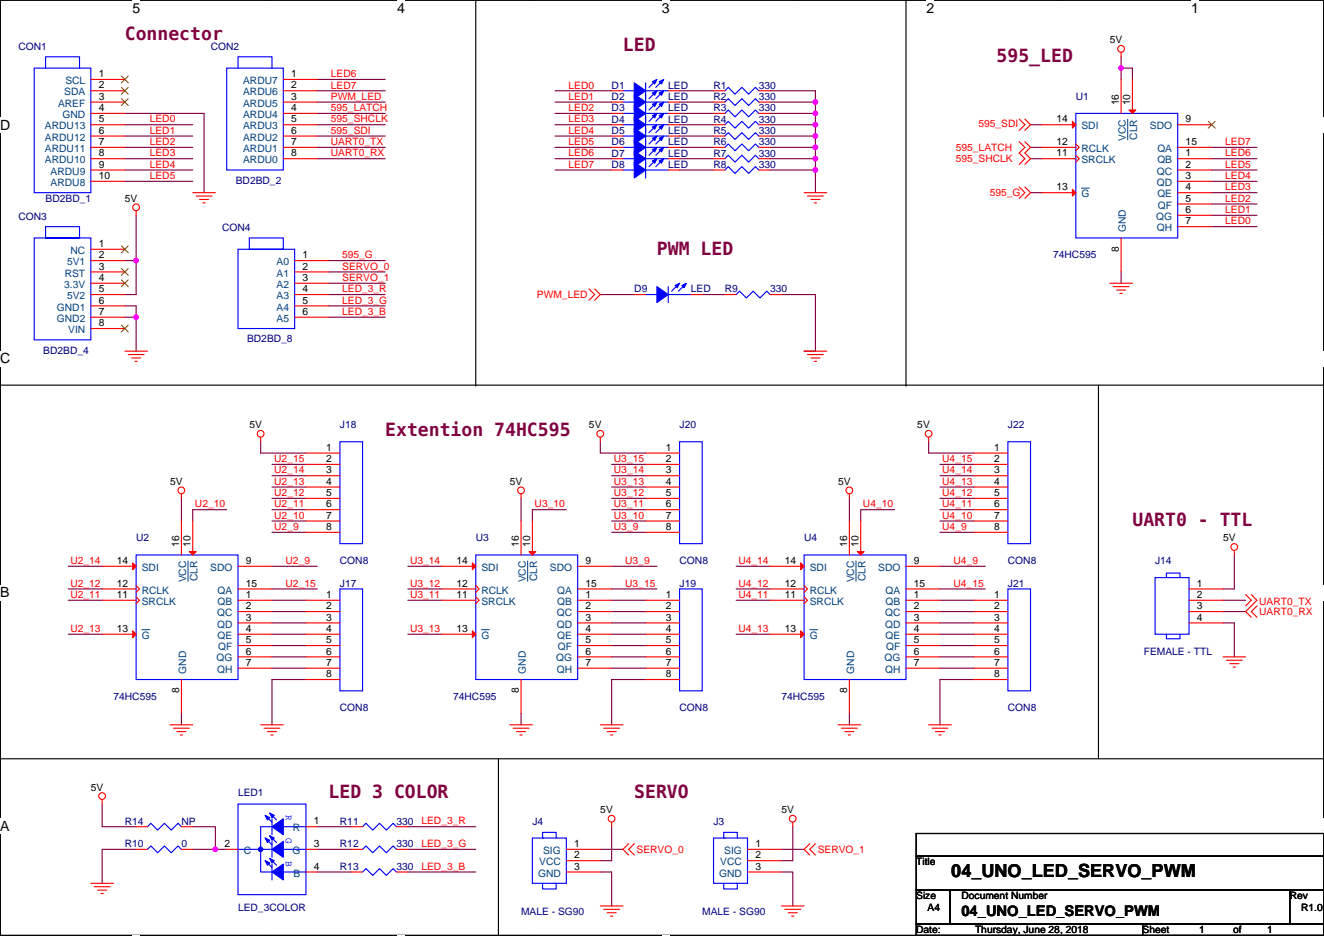
[picture p122: page 1]

5V LED 3 COLOR LED1 | SERVO 5V 5V J4 J3

Size Size Size A4 A4 A4 | Document Number Document Number Document Number 04_UNO_LED_SERVO_PWM 04_UNO_LED_SERVO_PWM 04_UNO_LED_SERVO_PWM | Rev Rev Rev R1.0 R1.0 R1.0

Date: Date: Date: Thursday, June 28, 2018 Thursday, June 28, 2018 Thursday, June 28, 2018 | Sheet Sheet Sheet 1 1 1 of of of 1 1 1
