riversnails/narsha_database/study/pads/cads/sample/SCHEMATIC1 _ 1_STM32F103.pdf

# XTAL_8MHz

# XTAL_32.768KHz

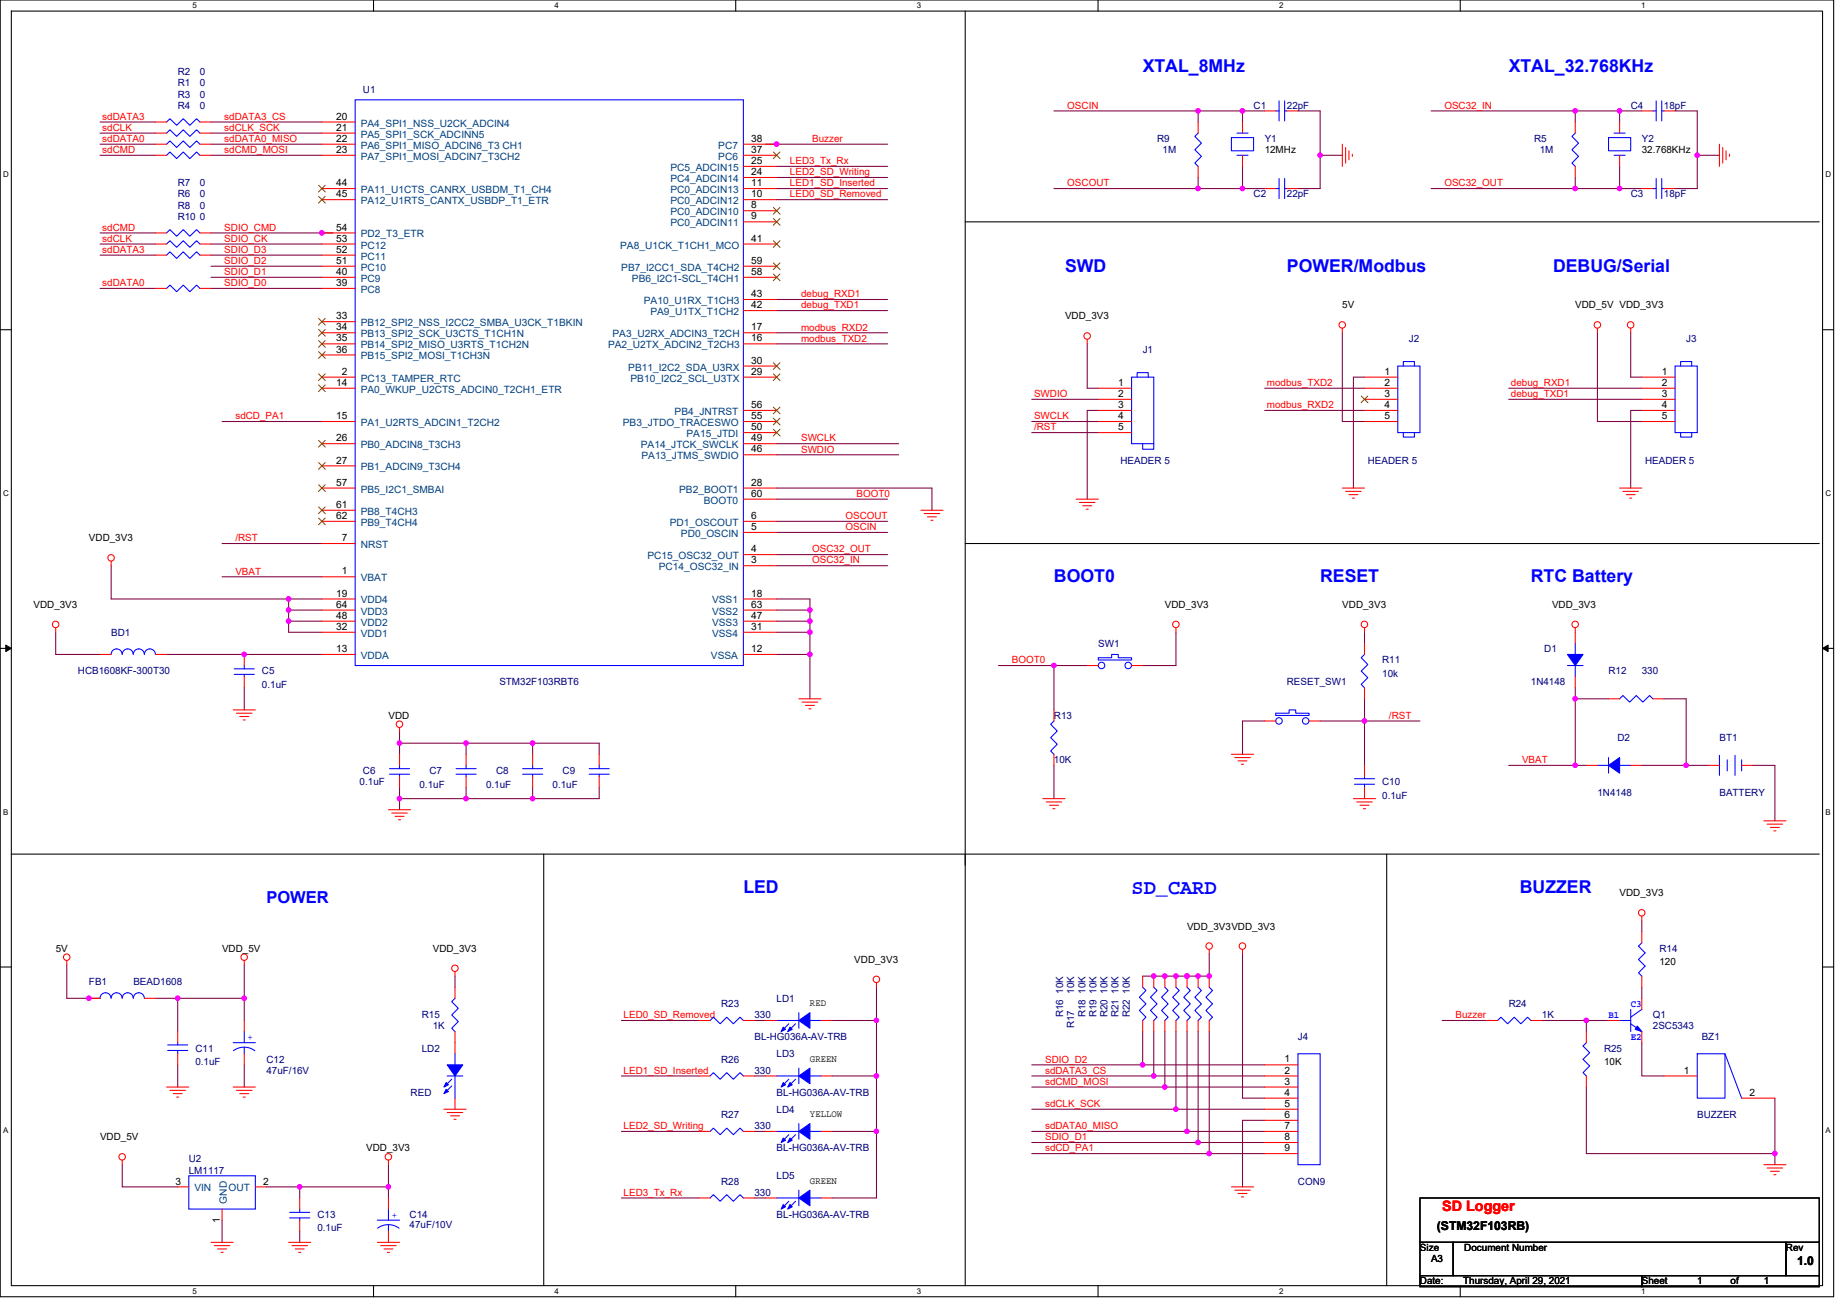
[picture p123: page 1]

Size Size Size A3 A3 A3 | Document Number Document Number Document Number | Rev Rev Rev 1.0 1.0 1.0

Date: Date: Date: Thursday, April 29, 2021 Thursday, April 29, 2021 Thursday, April 29, 2021 | Sheet Sheet Sheet 1 1 1 of of of 1 1 1
