riversnails/narsha_database/study/arm/STM32F407Z_open-407Z/Open407Z_C_schematic/CoreX07Z.pdf

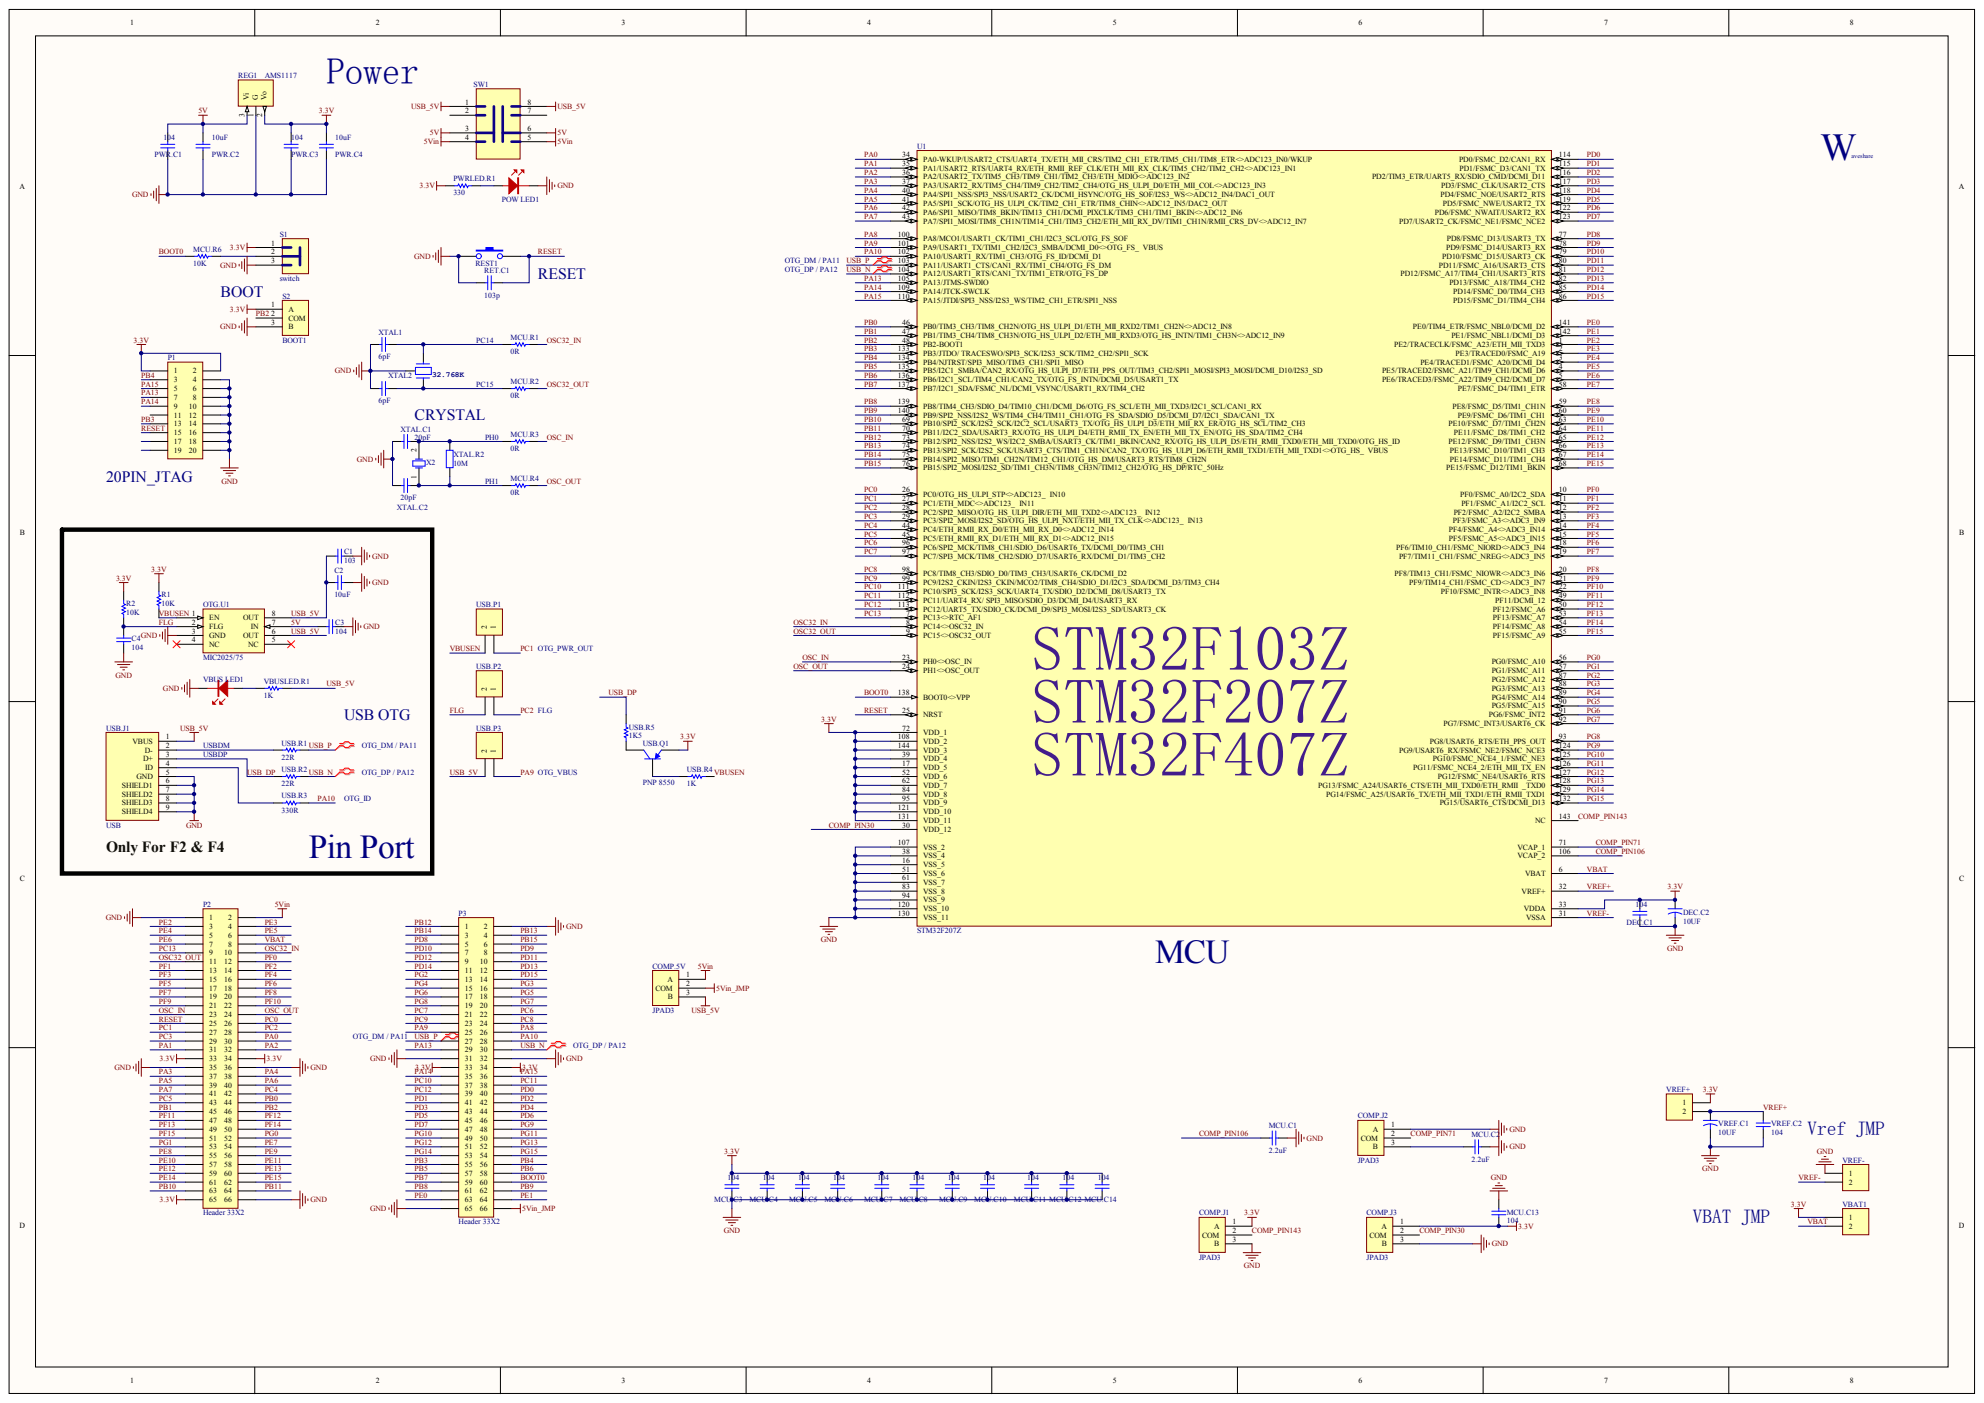
[picture p124: page 1]

VSS_4 38
VSS_5 16
VSS_6 51
VSS_7 61
VSS_8 83
VSS_9 94
VSS_10 120
