riversnails/narsha_database/study/arm/STM32F407Z_open-407Z/Open407Z_C_schematic/OpenX07Z-C.pdf

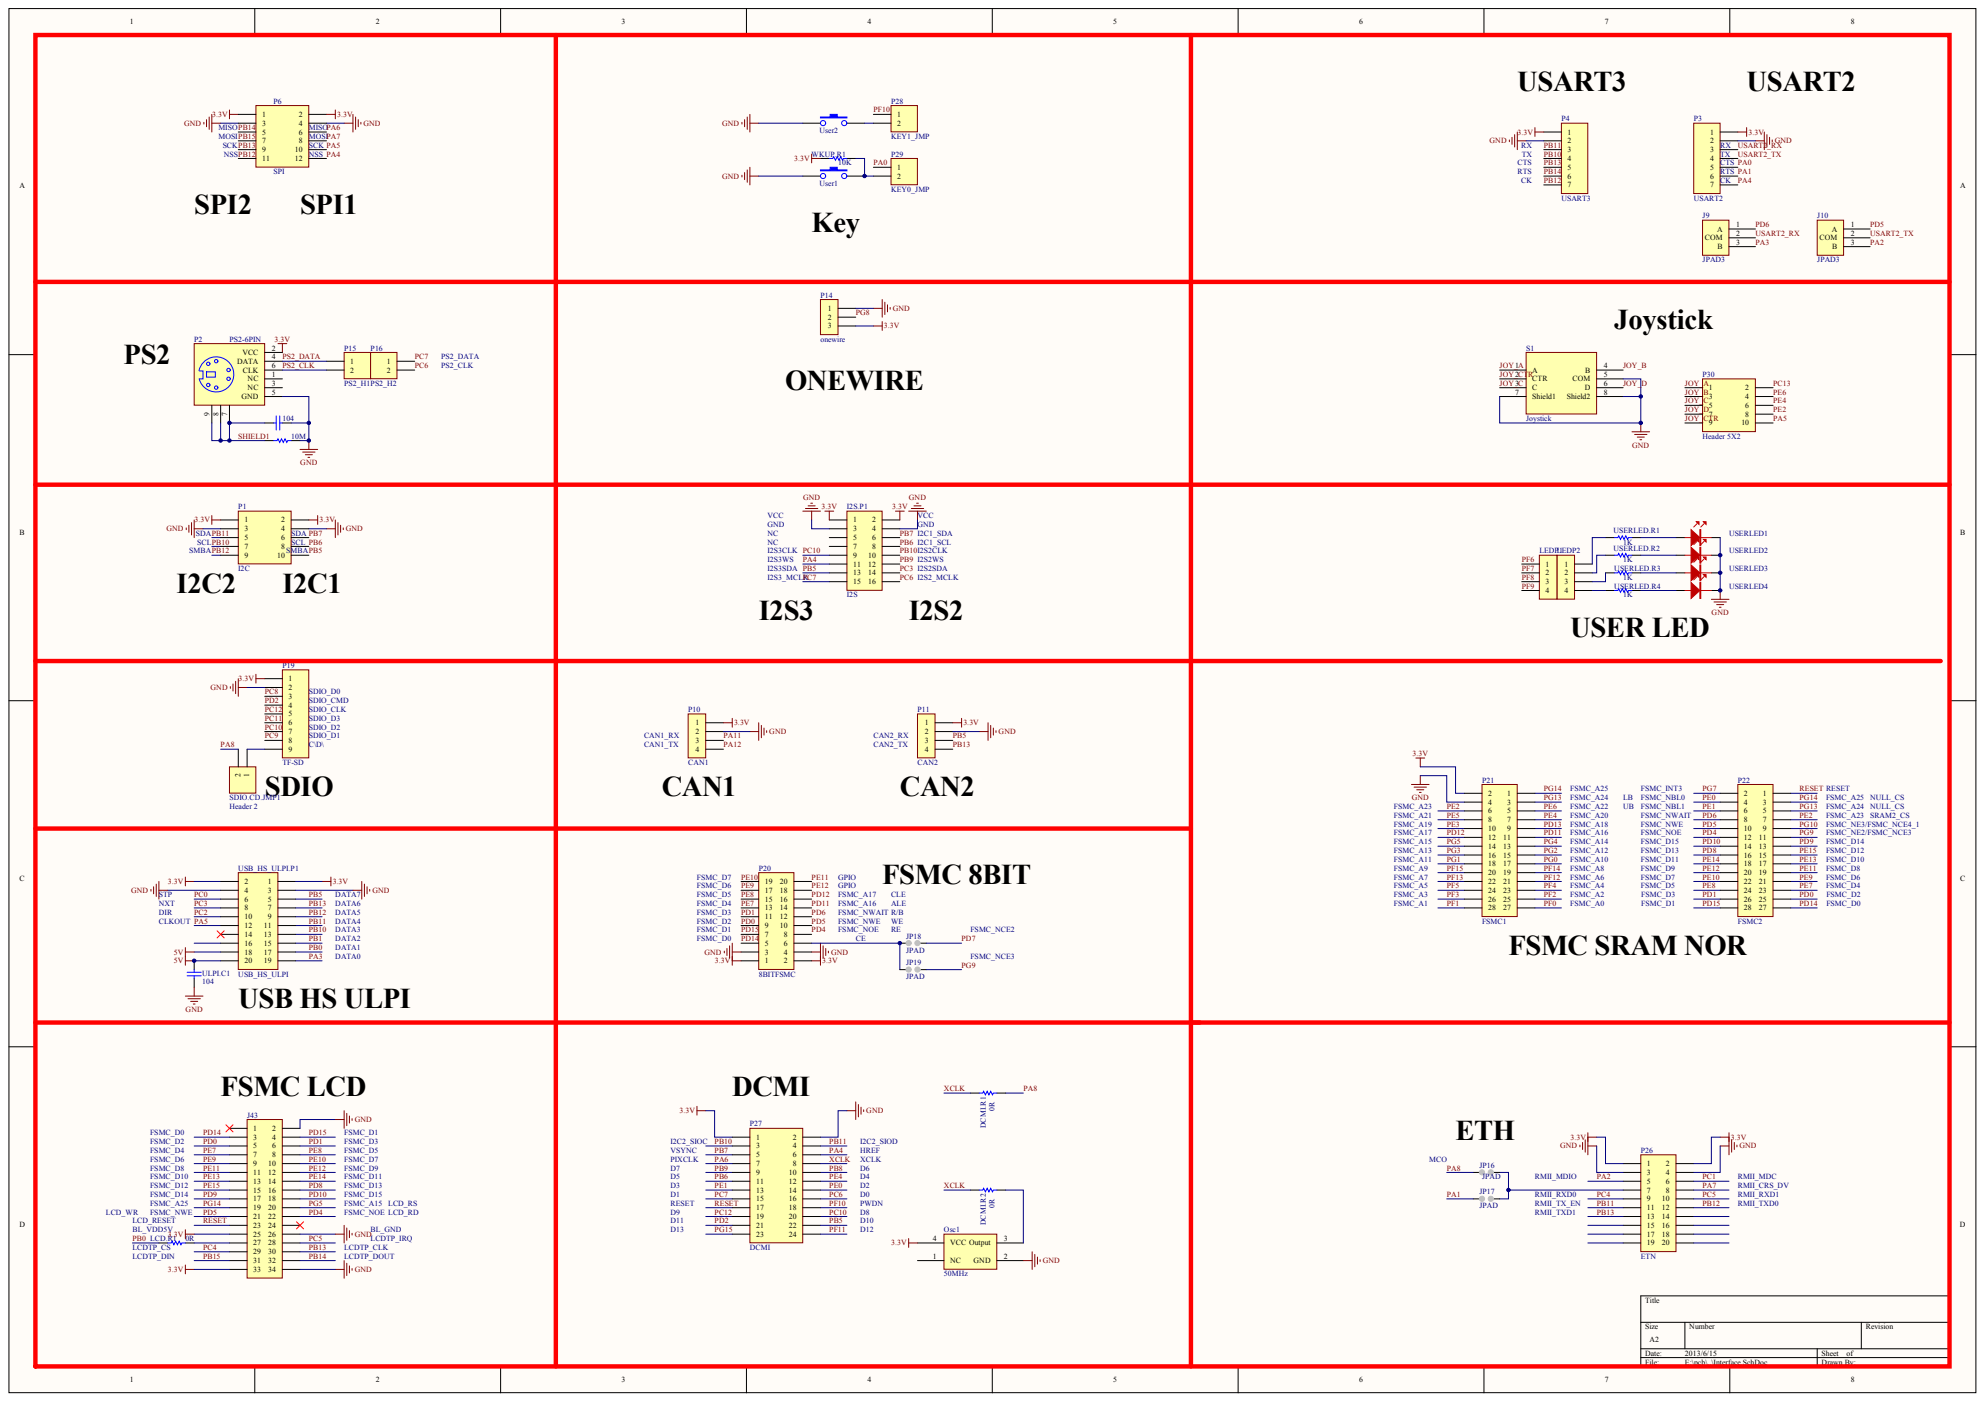
[picture p125: page 1]

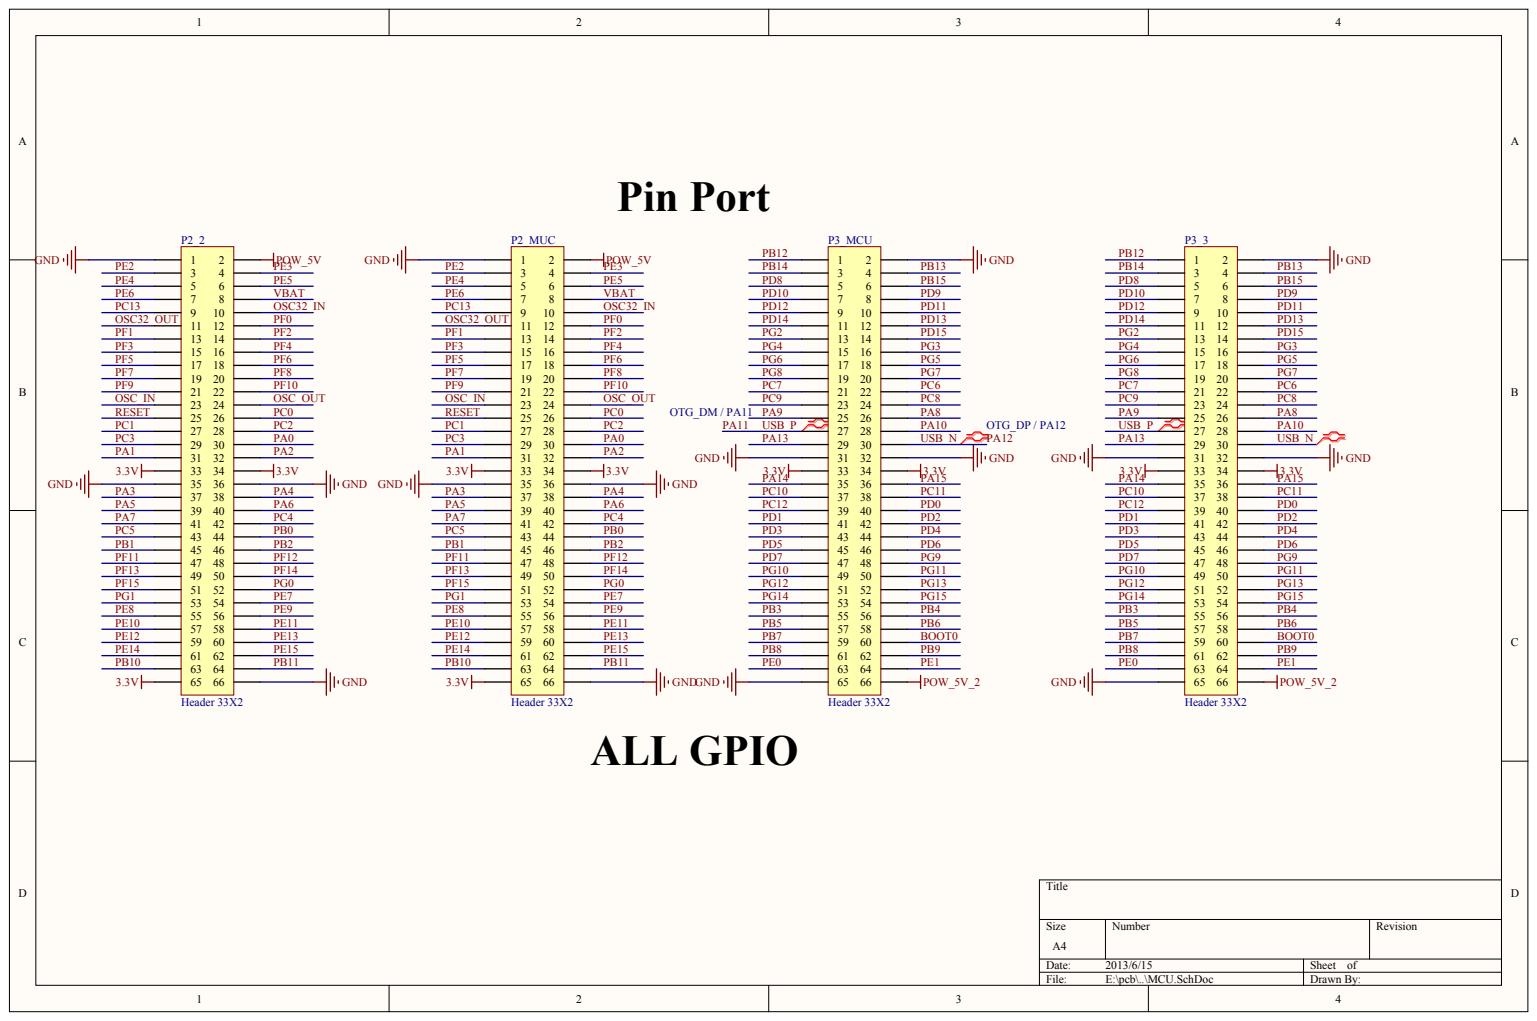
[picture p126: page 2]

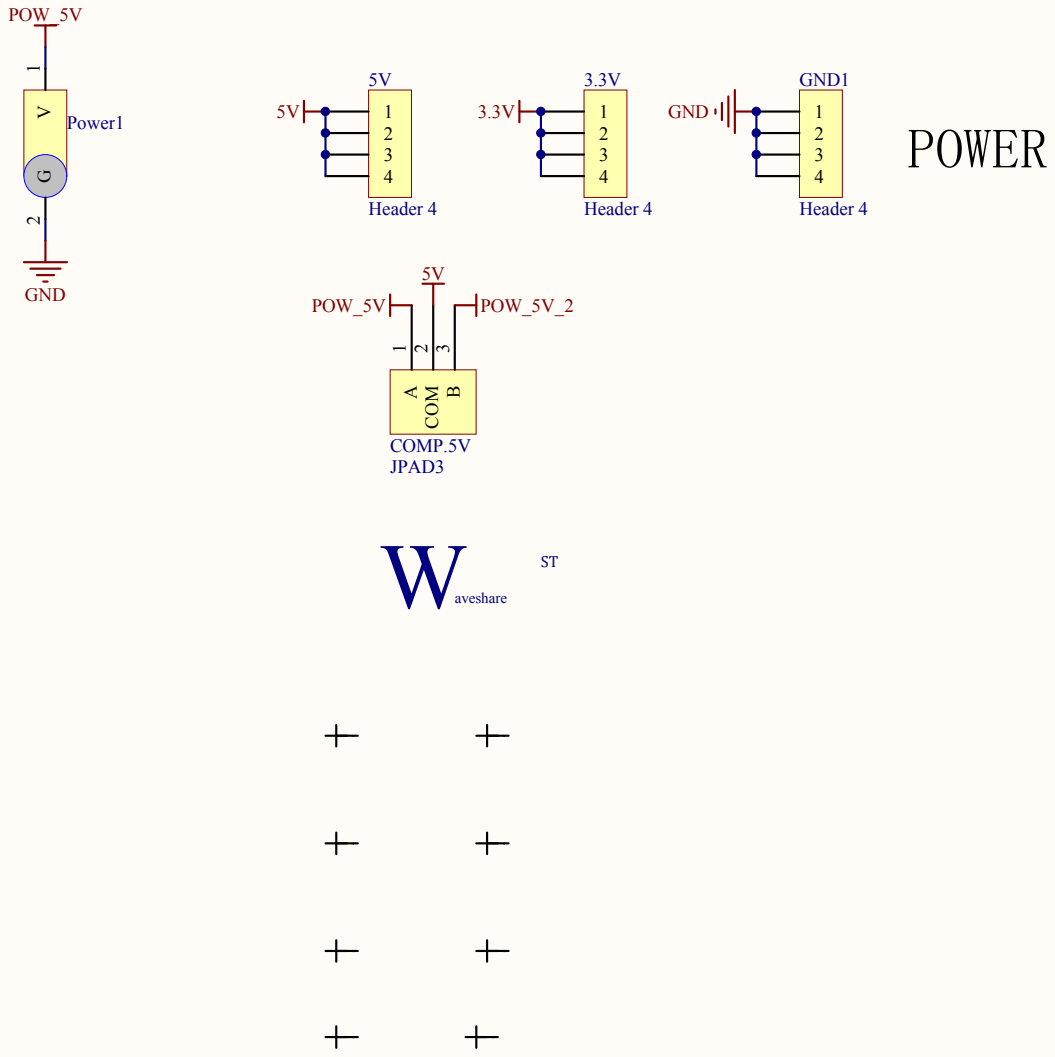
[picture p127: page 3]
