riversnails/narsha_database/(list of files, drawings)

Other design files:
study/pads/AM_MICOM_BASE_R2_schem_pcb_r2_0_6_orig/AM_MICOM_BASE_R2_schem_pcb_r2_0_6_orig/pcb_r2_0_6/PCB_AM_MICOM_BASE_R2_0_6.pcb
study/pads/AM_MICOM_BASE_R2_schem_pcb_r2_0_6_orig/AM_MICOM_BASE_R2_schem_pcb_r2_0_6_orig/schem_r2_0_6/AM_MICOM_BASE-R2_0_4.DSN
study/pads/AM_MICOM_BASE_R2_schem_pcb_r2_0_6_orig/AM_MICOM_BASE_R2_schem_pcb_r2_0_6_orig/schem_r2_0_6/am_micom_base-r2_0_4.opj
study/pads/cads/sample/AM32F103-V1.DSN
study/pads/cads/sample/AM32F103-v1.opj
study/pads/cads/test/AM32F103-V1.DSN
study/pads/cads/test/AM32F103-v1.opj
study/pads/pads/pads_test_1_20210421/test_1/Uno_Led_Servo_Pwm.pcb
study/pads/pads/pads_test_1_20210421/test_1/Uno_Led_Servo_Pwm_test_1.pcb
study/pads/pads/pads_test_1_20210421/test_1/Uno_Led_Servo_Pwm_test_2.pcb
study/pads/pads/pads_test_1_20210421/test_1/Uno_Led_Servo_Pwm_test_3.pcb
study/pads/pads/uno_extension_1/uno_extension_1.pcb
