riversnails/narsha_database/study/arm/STM32F072_Cube_USB/Projects/STM32F072B-Discovery/Applications/USB_Device/HID_Standalone/Inc/main.h

/**
  ******************************************************************************
  * @file    USB_Device/HID_Standalone/Inc/main.h
  * @author  MCD Application Team
  * @brief   Header for main.c module
  ******************************************************************************
  * @attention
  *
  * <h2><center>&copy; Copyright (c) 2016 STMicroelectronics.
  * All rights reserved.</center></h2>
  *
  * This software component is licensed by ST under Ultimate Liberty license
  * SLA0044, the "License"; You may not use this file except in compliance with
  * the License. You may obtain a copy of the License at:
  *                             www.st.com/SLA0044
  *
  ******************************************************************************
  */

/* Define to prevent recursive inclusion -------------------------------------*/
#ifndef __MAIN_H
#define __MAIN_H

/* Includes ------------------------------------------------------------------*/
#include "stm32f072b_discovery.h"
#include "usbd_core.h"
#include "usbd_desc.h"
#include "usbd_hid.h"

/* Exported types ------------------------------------------------------------*/
/* Exported constants --------------------------------------------------------*/
/* Exported macro ------------------------------------------------------------*/

#define SS_Pin GPIO_PIN_7
#define SS_GPIO_Port GPIOB

/* Definition for SPIx clock resources */
#define SPIx                             SPI1
#define SPIx_CLK_ENABLE()                __HAL_RCC_SPI1_CLK_ENABLE()
#define SPIx_SCK_GPIO_CLK_ENABLE()       __HAL_RCC_GPIOB_CLK_ENABLE()
#define SPIx_MISO_GPIO_CLK_ENABLE()      __HAL_RCC_GPIOB_CLK_ENABLE()
#define SPIx_MOSI_GPIO_CLK_ENABLE()      __HAL_RCC_GPIOB_CLK_ENABLE()

#define SPIx_FORCE_RESET()               __HAL_RCC_SPI1_FORCE_RESET()
#define SPIx_RELEASE_RESET()             __HAL_RCC_SPI1_RELEASE_RESET()

/* Definition for SPIx Pins */
#define SPIx_SCK_PIN                     GPIO_PIN_3
#define SPIx_SCK_GPIO_PORT               GPIOB
#define SPIx_SCK_AF                      GPIO_AF0_SPI1
#define SPIx_MISO_PIN                    GPIO_PIN_4
#define SPIx_MISO_GPIO_PORT              GPIOB
#define SPIx_MISO_AF                     GPIO_AF0_SPI1
#define SPIx_MOSI_PIN                    GPIO_PIN_5
#define SPIx_MOSI_GPIO_PORT              GPIOB
#define SPIx_MOSI_AF                     GPIO_AF0_SPI1

/* Definition for USARTx clock resources */
#define USARTx                           USART1
#define USARTx_CLK_ENABLE()              __HAL_RCC_USART1_CLK_ENABLE()
#define USARTx_RX_GPIO_CLK_ENABLE()      __HAL_RCC_GPIOA_CLK_ENABLE()
#define USARTx_TX_GPIO_CLK_ENABLE()      __HAL_RCC_GPIOA_CLK_ENABLE()

#define USARTx_FORCE_RESET()             __HAL_RCC_USART1_FORCE_RESET()
#define USARTx_RELEASE_RESET()           __HAL_RCC_USART1_RELEASE_RESET()

/* Definition for USARTx Pins */
#define USARTx_TX_PIN                    GPIO_PIN_9
#define USARTx_TX_GPIO_PORT              GPIOA
#define USARTx_TX_AF                     GPIO_AF1_USART1
#define USARTx_RX_PIN                    GPIO_PIN_10
#define USARTx_RX_GPIO_PORT              GPIOA
#define USARTx_RX_AF                     GPIO_AF1_USART1

/* Size of Trasmission buffer */
#define TXBUFFERSIZE                      (COUNTOF(aTxBuffer) - 1)
/* Size of Reception buffer */
#define RXBUFFERSIZE                      TXBUFFERSIZE
  
/* Exported macro ------------------------------------------------------------*/
#define COUNTOF(__BUFFER__)   (sizeof(__BUFFER__) / sizeof(*(__BUFFER__)))
/* Exported functions ------------------------------------------------------- */

/* Uncomment the line below to select your USB clock source */
#define USE_USB_CLKSOURCE_CRSHSI48   1
//#define USE_USB_CLKSOURCE_PLL        1

#if !defined (USE_USB_CLKSOURCE_PLL) && !defined (USE_USB_CLKSOURCE_CRSHSI48)
 #error "Missing USB clock definition"
#endif
/* Exported functions ------------------------------------------------------- */
void GetPointerData(uint8_t *pbuf);

#endif /* __MAIN_H */

/************************ (C) COPYRIGHT STMicroelectronics *****END OF FILE****/
