riversnails/narsha_database/study/arm/STM32F4/GPIO_Key_LED/User/main.c

#include "stm32f4xx.h"
#include "KEY&LED.h"
#include <stdio.h>
#include <string.h>
#include <stdarg.h>
#include <math.h>
#include <stdlib.h>
#incldue "gcode_sample_480_string.h"

double xy_pos[480][2] = {
66.268 , 82.377,
66.527 , 82.217,
66.796 , 82.073,
67.072 , 81.946,
67.356 , 81.836,
67.647 , 81.743,
67.942 , 81.669,
68.241 , 81.613,
68.544 , 81.576,
68.848 , 81.557,
131.152, 81.557,
131.456, 81.576,
131.759, 81.613,
132.058, 81.669,
132.353, 81.743,
132.644, 81.836,
132.928, 81.946,
133.204, 82.073,
133.473, 82.217,
133.732, 82.377,
133.980, 82.553,
134.218, 82.744,
134.443, 82.950,
134.655, 83.168,
134.853, 83.400,
135.036, 83.643,
135.205, 83.897,
135.357, 84.160,
135.493, 84.433,
135.611, 84.714,
135.713, 85.001,
135.796, 85.294,
135.861, 85.591,
135.908, 85.892,
135.936, 86.196,
135.945, 86.500,
135.936, 86.804,
135.908, 87.108,
135.861, 87.409,
135.796, 87.706,
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
}; 

int fputc(int ch, FILE * f) {
	while (!(USART1->SR & (0x01 << 7))) {}
	USART1->DR = ch;
	return ch;
}

void TimingDelay_Decrement(void);


volatile unsigned long sys_count;
volatile unsigned int TimingDelay;
volatile unsigned long count_ms = 0;

unsigned long micros_10us()
{
	return sys_count;
}

void Delay(unsigned int nTime)
{ 
  TimingDelay = nTime;

  while(TimingDelay > 0);
}

void delay_ms(unsigned int ms) {
	Delay(ms * 100);
}

 void TimingDelay_Decrement(void)
{
  if (TimingDelay != 0x00)
  { 
    TimingDelay--;
  }
}

unsigned long millis()
{
	return count_ms;
}

unsigned long micros()
{
	int timer1_cnt = 0;
	TIM1->CR1 |= 0x00;
	timer1_cnt = TIM1->CNT;
	TIM1->CR1 |= 0x01;
	return count_ms*1000 + timer1_cnt;
}

enum{
	LEFT = 0,
	RIGHT,
	UP,
	DOWN
};

enum{
	STOPPED = 0,
	RUNNING
};

volatile double x_pos = 0;
volatile double y_pos = 0;

volatile int x_distance = 0;
volatile int y_distance = 0;

volatile int x_timer_toggle = 0;
volatile int x_step_count = 0;
volatile int x_motor_move_enable = STOPPED;

volatile int y_timer_toggle = 0;
volatile int y_step_count = 0;
volatile int y_motor_move_enable = STOPPED;

double xy_gcode[480][2];

void TIM1_UP_TIM10_IRQHandler (void) { 

	 if ((TIM1->SR & 0x0001) != 0) { 
		 
		 count_ms++;
		 
		 
		 TIM1->SR &= ~(1<<0); // clear UIF flag
	 }
	 
}

void TIM2_IRQHandler (void) {

	 if ((TIM2->SR & 0x0001) != 0) { 
		 
		 if(x_motor_move_enable)
		 {
			 if(x_timer_toggle == 0)
			 {
				 x_timer_toggle = 1;
				 GPIOE->ODR |= (0x01 << 9);
			 }
			 else
			 {
				 x_timer_toggle = 0;
				 GPIOE->ODR &= ~(0x01 << 9);
				 
				 x_step_count++;
				 if(x_step_count >= x_distance)
				 {
					 x_step_count = 0;
					 x_motor_move_enable = STOPPED;
				 }
			 }
		}
		 
		 
		 TIM2->SR &= ~(1<<0); // clear UIF flag
	 }
	 
}

void TIM3_IRQHandler (void) {
	 if ((TIM3->SR & 0x0001) != 0) { 
		 if(y_motor_move_enable)
		 {
			 if(y_timer_toggle == 0)
			 {
				 y_timer_toggle = 1;
				 GPIOE->ODR |= (0x01 << 11);
			 }
			 else
			 {
				 y_timer_toggle = 0;
				 GPIOE->ODR &= ~(0x01 << 11);
				 
				 y_step_count++;
				 if(y_step_count >= y_distance)
				 {
					 y_step_count = 0;
					 y_motor_move_enable = STOPPED;
				 }
			 }
		}
		 
		 
		 TIM3->SR &= ~(1<<0); // clear UIF flag
	 }
	 
}

int stop_check()
{
	return x_motor_move_enable | y_motor_move_enable;
}

void direction_set(char dir)
{
	if(dir == LEFT)
	{
		GPIOF->ODR &= ~(0x01 << 1);
	}
	else if(dir == RIGHT)
	{
		GPIOF->ODR |= (0x01 << 1);
	}
	else if(dir == UP)
	{
		GPIOE->ODR |= (0x01 << 8);
	}
	else if(dir == DOWN)
	{
		GPIOE->ODR &= ~(0x01 << 8);
	}
}

void x_motor_move(char dir, int speed)
{
	direction_set(dir);
	TIM2->ARR = speed-1;
	TIM2->CNT = 0x00;
	x_motor_move_enable = RUNNING;
}

void y_motor_move(char dir, int speed)
{
	direction_set(dir);
	TIM3->ARR = speed-1;
	TIM3->CNT = 0x00;
	y_motor_move_enable = RUNNING;
}




void motor_move(double x, double y, int speed)
{
	double x_dis = (double)(x - x_pos);
	double y_dis = (double)(y - y_pos);
	double angle;
	double x_speed;
	double y_speed;
	double distance_per_sec;
	char x_dir = RIGHT;
	char y_dir = UP;
	
	 x_speed = speed;
   y_speed = speed;
	angle = atan2(y_dis, x_dis);
	
	if(x_dis < 0) 
	{
		x_dis = fabs(x_dis);
		x_dir = LEFT;
	}
	if(y_dis < 0) 
	{
		y_dis = fabs(y_dis);
		y_dir = DOWN;
	}
	
	x_distance = (int)(x_dis * 80);
	y_distance = (int)(y_dis * 80);
	
	distance_per_sec = ((1/ (((double)speed / 60.0)*80) )* 1000000) / 2;
	
	if(x_dis == 0)
	{
		y_speed = distance_per_sec * (double)(1 / fabs(sin(angle)) );
		y_motor_move(y_dir, (int)y_speed);
	}
	else if(y_dis == 0)
	{
		x_speed = distance_per_sec * (double)(1 / fabs(cos(angle)) );
		x_motor_move(x_dir, (int)x_speed);
	}
	else if(x_dis != 0 && y_dis != 0)
	{
		x_speed = (int)(distance_per_sec * (double)(1 / fabs(cos(angle)) ));
		y_speed = (int)(distance_per_sec * (double)(1 / fabs(sin(angle)) ));
		x_motor_move(x_dir, (int)x_speed);
		y_motor_move(y_dir, (int)y_speed);
	}
	
	x_pos = x;
	y_pos = y;
}

void timer_set()
{
	//timer1
	RCC->APB2ENR |= 0x01 << 0;
	TIM1->CR1 |= 0x01;
	TIM1->PSC = 168 - 1;
	TIM1->ARR = 1000 - 1;
	TIM1->CNT = 0x00;
	TIM1->DIER |= 0x01;
	NVIC->ISER[0] |= (0x01 << 25);
	
	//timer2
	RCC->APB1ENR |= 0x01 << 0;
	TIM2->CR1 |= 0x01;
	TIM2->PSC = 84 - 1;
	TIM2->ARR = 200 - 1;
	TIM2->CNT = 0x00;
	TIM2->DIER |= 0x01;
	NVIC->ISER[0] |= (0x01 << 28);
	
	//timer3
	RCC->APB1ENR |= 0x01 << 1;
	TIM3->CR1 |= 0x01;
	TIM3->PSC = 84 - 1;
	TIM3->ARR = 200 - 1;
	TIM3->CNT = 0x00;
	TIM3->DIER |= 0x01;
	NVIC->ISER[0] |= (0x01 << 29);
}

GPIO_InitTypeDef  GPIO_InitStructure;
USART_InitTypeDef USART_InitStructure;

void motor_set()
{
	RCC_AHB1PeriphClockCmd(RCC_AHB1Periph_GPIOA, ENABLE);
	RCC_AHB1PeriphClockCmd(RCC_AHB1Periph_GPIOC, ENABLE);
	RCC_AHB1PeriphClockCmd(RCC_AHB1Periph_GPIOD, ENABLE);
	RCC_AHB1PeriphClockCmd(RCC_AHB1Periph_GPIOE, ENABLE);
	RCC_AHB1PeriphClockCmd(RCC_AHB1Periph_GPIOF, ENABLE);

	//led
	GPIO_InitStructure.GPIO_Pin = GPIO_Pin_7;
	GPIO_InitStructure.GPIO_Mode = GPIO_Mode_OUT;
	GPIO_InitStructure.GPIO_OType = GPIO_OType_PP;
	GPIO_InitStructure.GPIO_Speed = GPIO_Speed_100MHz;
	GPIO_InitStructure.GPIO_PuPd = GPIO_PuPd_UP;
	GPIO_Init(GPIOA, &GPIO_InitStructure);

	//x_step
	GPIO_InitStructure.GPIO_Pin = GPIO_Pin_9;
	GPIO_InitStructure.GPIO_Mode = GPIO_Mode_OUT;
	GPIO_InitStructure.GPIO_OType = GPIO_OType_PP;
	GPIO_InitStructure.GPIO_Speed = GPIO_Speed_100MHz;
	GPIO_InitStructure.GPIO_PuPd = GPIO_PuPd_UP;
	GPIO_Init(GPIOE, &GPIO_InitStructure);

//x_dir, x_en
	GPIO_InitStructure.GPIO_Pin = GPIO_Pin_1 | GPIO_Pin_2;
	GPIO_InitStructure.GPIO_Mode = GPIO_Mode_OUT;
	GPIO_InitStructure.GPIO_OType = GPIO_OType_PP;
	GPIO_InitStructure.GPIO_Speed = GPIO_Speed_100MHz;
	GPIO_InitStructure.GPIO_PuPd = GPIO_PuPd_UP;
	GPIO_Init(GPIOF, &GPIO_InitStructure);

//y_step, y_dir
	GPIO_InitStructure.GPIO_Pin = GPIO_Pin_8 | GPIO_Pin_11;
	GPIO_InitStructure.GPIO_Mode = GPIO_Mode_OUT;
	GPIO_InitStructure.GPIO_OType = GPIO_OType_PP;
	GPIO_InitStructure.GPIO_Speed = GPIO_Speed_100MHz;
	GPIO_InitStructure.GPIO_PuPd = GPIO_PuPd_UP;
	GPIO_Init(GPIOE, &GPIO_InitStructure);

//y_en
	GPIO_InitStructure.GPIO_Pin = GPIO_Pin_7;
	GPIO_InitStructure.GPIO_Mode = GPIO_Mode_OUT;
	GPIO_InitStructure.GPIO_OType = GPIO_OType_PP;
	GPIO_InitStructure.GPIO_Speed = GPIO_Speed_100MHz;
	GPIO_InitStructure.GPIO_PuPd = GPIO_PuPd_UP;
	GPIO_Init(GPIOD, &GPIO_InitStructure);

//z_step
	GPIO_InitStructure.GPIO_Pin = GPIO_Pin_13;
	GPIO_InitStructure.GPIO_Mode = GPIO_Mode_OUT;
	GPIO_InitStructure.GPIO_OType = GPIO_OType_PP;
	GPIO_InitStructure.GPIO_Speed = GPIO_Speed_100MHz;
	GPIO_InitStructure.GPIO_PuPd = GPIO_PuPd_UP;
	GPIO_Init(GPIOE, &GPIO_InitStructure);

//z_dir, z_en
	GPIO_InitStructure.GPIO_Pin = GPIO_Pin_0 | GPIO_Pin_2;
	GPIO_InitStructure.GPIO_Mode = GPIO_Mode_OUT;
	GPIO_InitStructure.GPIO_OType = GPIO_OType_PP;
	GPIO_InitStructure.GPIO_Speed = GPIO_Speed_100MHz;
	GPIO_InitStructure.GPIO_PuPd = GPIO_PuPd_UP;
	GPIO_Init(GPIOC, &GPIO_InitStructure);

	GPIOF->ODR |= ~(0x01 << 2);
	GPIOD->ODR |= ~(0x01 << 7);
	GPIOC->ODR |= ~(0x01 << 0);
}

#define SIZE_POINT 480
double pos_array[5][3] = {{50,0,2400}, {50,25,2400}, {0,0,2400}};

unsigned long p_millis = 0;
unsigned long c_millis = 0;
int toggle = 0;
int state = 0;
int i = 0;

int main(void)
{	
	
	int i = 0;
	
//	if (SysTick_Config(168000000 / 100000)) {
//		while (1);
//	}
	
	
	motor_set();
	timer_set();
	
	for()
	
	
	while(1)
	{
		if(stop_check() == 0)
		{
			motor_move((double)xy_pos[state][0], (double)xy_pos[state][1], 4800);
			state++;
			
			if(state == SIZE_POINT) break;
		}
	}
	
	while(1)
	{
		if(stop_check() == 0)
		{
			motor_move(pos_array[state][0], pos_array[state][1], pos_array[state][2]);
			state++;
			if(state == SIZE_POINT) state = 0;
		}
	}
	
	y_distance = 0.1*80;
	y_motor_move(DOWN, 1125);
	while(1);
	
	
	

	
	while(1);
	
	
	direction_set(RIGHT);
	x_motor_move_enable = RUNNING;
	
	
	
	while(1)
	{
		c_millis = millis();
		if(c_millis - p_millis >= 300)
		{
			p_millis = c_millis;
			if(toggle == 0)
			 {
				 toggle = 1;
				 GPIOA->ODR |= (0x01 << 7);
			 }
			 else
			 {
				 toggle = 0;
				 GPIOA->ODR &= ~(0x01 << 7);
			 }
		 }
		
		 
		 if(state == 0)
		 {
				if(x_motor_move_enable == 0 && y_motor_move_enable == 0) 
				{
					direction_set(UP);
					y_motor_move_enable = RUNNING;
					state++;
				}
		 }
		 else if(state == 1)
		 {
			 if(x_motor_move_enable == 0 && y_motor_move_enable == 0) 
				{
					direction_set(LEFT);
					x_motor_move_enable = RUNNING;
					state++;
				}
		 }
		 else if(state == 2)
		 {
			 if(x_motor_move_enable == 0 && y_motor_move_enable == 0) 
				{
					direction_set(DOWN);
					y_motor_move_enable = RUNNING;
					state++;
				}
		 }
		 else if(state == 3)
		 {
			 if(x_motor_move_enable == 0 && y_motor_move_enable == 0) 
				{
					direction_set(RIGHT);
					x_motor_move_enable = RUNNING;
					state++;
				}
		 }
	}
	
	
	while(1)
	{
		// high 
		GPIOF->ODR |= (0x01 << 1);
	for(i = 0; i < 3200; i++)
	{
		Delay(20);
		GPIOE->ODR |= (0x01 << 9);
		Delay(20);
		GPIOE->ODR &= ~(0x01 << 9);
	}
	
	GPIOE->ODR |= (0x01 << 8);
	for(i = 0; i < 3200; i++)
	{
		Delay(20);
		GPIOE->ODR |= (0x01 << 11);
		Delay(20);
		GPIOE->ODR &= ~(0x01 << 11);
	}
	
	GPIOC->ODR |= (0x01 << 2);
	for(i = 0; i < 3200; i++)
	{
		Delay(20);
		GPIOE->ODR |= (0x01 << 13);
		Delay(20);
		GPIOE->ODR &= ~(0x01 << 13);
	}
		
		// low
	GPIOF->ODR &= ~(0x01 << 1);
	for(i = 0; i < 3200; i++)
	{
		Delay(20);
		GPIOE->ODR |= (0x01 << 9);
		Delay(20);
		GPIOE->ODR &= ~(0x01 << 9);
	}
	
	GPIOE->ODR &= ~(0x01 << 8);
	for(i = 0; i < 3200; i++)
	{
		Delay(20);
		GPIOE->ODR |= (0x01 << 11);
		Delay(20);
		GPIOE->ODR &= ~(0x01 << 11);
	}
	
	GPIOC->ODR &= ~(0x01 << 2);
	for(i = 0; i < 3200; i++)
	{
		Delay(20);
		GPIOE->ODR |= (0x01 << 13);
		Delay(20);
		GPIOE->ODR &= ~(0x01 << 13);
	}
	
	
	while(1);
}
	
	
	while(1) {
		// 200 us
//		Delay(20);
//		GPIOE->ODR |= (0x01 << 9);
//		Delay(20);
//		GPIOE->ODR &= ~(0x01 << 9);
		delay_ms(1000);
		GPIOA->ODR |= (0x01 << 7);
		delay_ms(1000);
		GPIOA->ODR &= ~(0x01 << 7);
	}
	
	
}


// X STEP PE9
// X DIR PF1
// X EN PF2
// Y STEP PE11
// Y DIR PE8
// Y EN PD7
// Z STEP PE13
// Z DIR PC2
// Z EN PC0
