riversnails/narsha_database/study/arm/STM32F407Z_open-407Z/Open407Z-C/DCMI_0V7670/User/config.h

#ifndef _CONFIG_H
#define _CONFIG_H

#include <stdio.h>
#include "stm32f4xx.h"

/**
 * @brief Definition for COM port1, connected to USART1
 */ 
	#define Open_USART                        USART3
	#define Open_USART_CLK                    RCC_APB1Periph_USART3
	
	#define Open_USART_TX_PIN                 GPIO_Pin_10
	#define Open_USART_TX_GPIO_PORT           GPIOB
	#define Open_USART_TX_GPIO_CLK            RCC_AHB1Periph_GPIOA
	#define Open_USART_TX_SOURCE              GPIO_PinSource10
	#define Open_USART_TX_AF                  GPIO_AF_USART3
	
	
	#define Open_USART_RX_PIN                 GPIO_Pin_11
	#define Open_USART_RX_GPIO_PORT           GPIOB
	#define Open_USART_RX_GPIO_CLK            RCC_AHB1Periph_GPIOB
	#define Open_USART_RX_SOURCE              GPIO_PinSource11
	#define Open_USART_RX_AF                  GPIO_AF_USART3
	
	#define Open_USART_IRQn                   USART3_IRQn


/* DCMI Communication boards Interface */

/**
 * @connected to I2C2
 */
 /* Configure I2C1 pins: PB10->SIOC and PB11->SIOD */ 
#define Open_SCCB                        	I2C2
#define Open_SCCB_CLK                    	RCC_APB1Periph_I2C2

#define Open_SCCB_SDA_PIN                 	GPIO_Pin_10
#define Open_SCCB_SDA_GPIO_PORT           	GPIOB
#define Open_SCCB_SDA_GPIO_CLK            	RCC_AHB1Periph_GPIOB
#define Open_SCCB_SDA_SOURCE              	GPIO_PinSource10
#define Open_SCCB_SDA_AF                  	GPIO_AF_I2C2

#define Open_SCCB_SCL_PIN                 	GPIO_Pin_11
#define Open_SCCB_SCL_GPIO_PORT           	GPIOB
#define Open_SCCB_SCL_GPIO_CLK            	RCC_AHB1Periph_GPIOB
#define Open_SCCB_SCL_SOURCE              	GPIO_PinSource11
#define Open_SCCB_SCL_AF                  	GPIO_AF_I2C2

#endif	  /*_CONFIG_H*/
