riversnails/narsha_database/study/arm/lecture/UART/main_uart_printf.c

/**
  ******************************************************************************
  * @file    USART/Printf/main.c 
  * @author  MCD Application Team
  * @version V3.5.0
  * @date    08-April-2011
  * @brief   Main program body
  ******************************************************************************
  * @attention
  *
  * THE PRESENT FIRMWARE WHICH IS FOR GUIDANCE ONLY AIMS AT PROVIDING CUSTOMERS
  * WITH CODING INFORMATION REGARDING THEIR PRODUCTS IN ORDER FOR THEM TO SAVE
  * TIME. AS A RESULT, STMICROELECTRONICS SHALL NOT BE HELD LIABLE FOR ANY
  * DIRECT, INDIRECT OR CONSEQUENTIAL DAMAGES WITH RESPECT TO ANY CLAIMS ARISING
  * FROM THE CONTENT OF SUCH FIRMWARE AND/OR THE USE MADE BY CUSTOMERS OF THE
  * CODING INFORMATION CONTAINED HEREIN IN CONNECTION WITH THEIR PRODUCTS.
  *
  * <h2><center>&copy; COPYRIGHT 2011 STMicroelectronics</center></h2>
  ******************************************************************************
  */ 

/* Includes ------------------------------------------------------------------*/
#include "stm32f10x.h"
#include "stm32_eval.h"
#include <stdio.h>

/** @addtogroup STM32F10x_StdPeriph_Examples
  * @{
  */

/** @addtogroup USART_Printf
  * @{
  */ 

/* Private typedef -----------------------------------------------------------*/
/* Private define ------------------------------------------------------------*/
/* Private macro -------------------------------------------------------------*/
/* Private variables ---------------------------------------------------------*/
USART_InitTypeDef USART_InitStructure;

/* Private function prototypes -----------------------------------------------*/

#ifdef __GNUC__
  /* With GCC/RAISONANCE, small printf (option LD Linker->Libraries->Small printf
     set to 'Yes') calls __io_putchar() */
  #define PUTCHAR_PROTOTYPE int __io_putchar(int ch)
#else
  #define PUTCHAR_PROTOTYPE int fputc(int ch, FILE *f)
#endif /* __GNUC__ */
  
/* Private functions ---------------------------------------------------------*/

int ScanKey (void)  {

  while (!(USART1->SR & USART_FLAG_RXNE));

  return ((int)(USART1->DR & 0x1FF));
}

int GetKey (void)  {

  return ((int)(USART1->DR & 0x1FF));
}

int GetKey_Received(void)
{
  if (USART1->SR & USART_FLAG_RXNE)
  	return 1;
  else
  	return 0;
//  return ((int)(USART1->DR & 0x1FF));	
}
#if 0
void STM_COMInit(COM_TypeDef COM, USART_InitTypeDef* USART_InitStruct)
{
  GPIO_InitTypeDef GPIO_InitStructure;

  /* Enable GPIO clock */
  RCC_APB2PeriphClockCmd(COM_TX_PORT_CLK[COM] | COM_RX_PORT_CLK[COM] | RCC_APB2Periph_AFIO, ENABLE);

  if (COM == COM1)
  {
    RCC_APB2PeriphClockCmd(COM_USART_CLK[COM], ENABLE); 
  }
  else
  {
    /* Enable the USART2 Pins Software Remapping */
    GPIO_PinRemapConfig(GPIO_Remap_USART2, ENABLE);
    RCC_APB1PeriphClockCmd(COM_USART_CLK[COM], ENABLE);
  }

  /* Configure USART Tx as alternate function push-pull */
  GPIO_InitStructure.GPIO_Mode = GPIO_Mode_AF_PP;
  GPIO_InitStructure.GPIO_Pin = COM_TX_PIN[COM];
  GPIO_InitStructure.GPIO_Speed = GPIO_Speed_50MHz;
  GPIO_Init(COM_TX_PORT[COM], &GPIO_InitStructure);


  /* Configure USART Rx as input floating */
  GPIO_InitStructure.GPIO_Mode = GPIO_Mode_IN_FLOATING;
  GPIO_InitStructure.GPIO_Pin = COM_RX_PIN[COM];
  GPIO_Init(COM_RX_PORT[COM], &GPIO_InitStructure);

  /* USART configuration */
  USART_Init(COM_USART[COM], USART_InitStruct);
    
  /* Enable USART */
  USART_Cmd(COM_USART[COM], ENABLE);
}

#define COMn                             2

/**
 * @brief Definition for COM port1, connected to USART2
 */ 
#define EVAL_COM1                        USART2
#define EVAL_COM1_CLK                    RCC_APB1Periph_USART2

#define EVAL_COM1_TX_PIN                 GPIO_Pin_5
#define EVAL_COM1_TX_GPIO_PORT           GPIOD
#define EVAL_COM1_TX_GPIO_CLK            RCC_AHBPeriph_GPIOD
#define EVAL_COM1_TX_SOURCE              GPIO_PinSource5
#define EVAL_COM1_TX_AF                  GPIO_AF_USART2

#define EVAL_COM1_RX_PIN                 GPIO_Pin_6
#define EVAL_COM1_RX_GPIO_PORT           GPIOD
#define EVAL_COM1_RX_GPIO_CLK            RCC_AHBPeriph_GPIOD
#define EVAL_COM1_RX_SOURCE              GPIO_PinSource6
#define EVAL_COM1_RX_AF                  GPIO_AF_USART2

#define EVAL_COM1_RTS_PIN                GPIO_Pin_4
#define EVAL_COM1_RTS_GPIO_PORT          GPIOD
#define EVAL_COM1_RTS_GPIO_CLK           RCC_AHBPeriph_GPIOD
#define EVAL_COM1_RTS_SOURCE             GPIO_PinSource4
#define EVAL_COM1_RTS_AF                 GPIO_AF_USART2

#define EVAL_COM1_CTS_PIN                GPIO_Pin_3
#define EVAL_COM1_CTS_GPIO_PORT          GPIOD
#define EVAL_COM1_CTS_GPIO_CLK           RCC_AHBPeriph_GPIOD
#define EVAL_COM1_CTS_SOURCE             GPIO_PinSource3
#define EVAL_COM1_CTS_AF                 GPIO_AF_USART2

#define EVAL_COM1_IRQn                   USART2_IRQn


#define EVAL_COM2                        USART3
#define EVAL_COM2_CLK                    RCC_APB1Periph_USART3

#define EVAL_COM2_TX_PIN                 GPIO_Pin_10
#define EVAL_COM2_TX_GPIO_PORT           GPIOC
#define EVAL_COM2_TX_GPIO_CLK            RCC_AHBPeriph_GPIOC
#define EVAL_COM2_TX_SOURCE              GPIO_PinSource10
#define EVAL_COM2_TX_AF                  GPIO_AF_USART3

#define EVAL_COM2_RX_PIN                 GPIO_Pin_11
#define EVAL_COM2_RX_GPIO_PORT           GPIOC
#define EVAL_COM2_RX_GPIO_CLK            RCC_AHBPeriph_GPIOC
#define EVAL_COM2_RX_SOURCE              GPIO_PinSource11
#define EVAL_COM2_RX_AF                  GPIO_AF_USART3

#define EVAL_COM2_IRQn                   USART3_IRQn

/*
#define EVAL_COM1                        USART2
#define EVAL_COM1_CLK                    RCC_APB1Periph_USART2
#define EVAL_COM1_TX_PIN                 GPIO_Pin_5
#define EVAL_COM1_TX_GPIO_PORT           GPIOD
#define EVAL_COM1_TX_GPIO_CLK            RCC_APB2Periph_GPIOD
#define EVAL_COM1_RX_PIN                 GPIO_Pin_6
#define EVAL_COM1_RX_GPIO_PORT           GPIOD
#define EVAL_COM1_RX_GPIO_CLK            RCC_APB2Periph_GPIOD
#define EVAL_COM1_IRQn                   USART2_IRQn

#define EVAL_COM2                        USART2
#define EVAL_COM2_CLK                    RCC_APB1Periph_USART2
#define EVAL_COM2_TX_PIN                 GPIO_Pin_5
#define EVAL_COM2_TX_GPIO_PORT           GPIOD
#define EVAL_COM2_TX_GPIO_CLK            RCC_APB2Periph_GPIOD
#define EVAL_COM2_RX_PIN                 GPIO_Pin_6
#define EVAL_COM2_RX_GPIO_PORT           GPIOD
#define EVAL_COM2_RX_GPIO_CLK            RCC_APB2Periph_GPIOD
#define EVAL_COM2_IRQn                   USART2_IRQn
*/


USART_TypeDef* COM_USART[COMn] = {EVAL_COM1, EVAL_COM2}; 

GPIO_TypeDef* COM_TX_PORT[COMn] = {EVAL_COM1_TX_GPIO_PORT, EVAL_COM2_TX_GPIO_PORT};
 
GPIO_TypeDef* COM_RX_PORT[COMn] = {EVAL_COM1_RX_GPIO_PORT, EVAL_COM2_RX_GPIO_PORT};

const uint32_t COM_USART_CLK[COMn] = {EVAL_COM1_CLK, EVAL_COM2_CLK};

const uint32_t COM_TX_PORT_CLK[COMn] = {EVAL_COM1_TX_GPIO_CLK, EVAL_COM2_TX_GPIO_CLK};
 
const uint32_t COM_RX_PORT_CLK[COMn] = {EVAL_COM1_RX_GPIO_CLK, EVAL_COM2_RX_GPIO_CLK};

const uint16_t COM_TX_PIN[COMn] = {EVAL_COM1_TX_PIN, EVAL_COM2_TX_PIN};

const uint16_t COM_RX_PIN[COMn] = {EVAL_COM1_RX_PIN, EVAL_COM2_RX_PIN};
 
const uint16_t COM_TX_PIN_SOURCE[COMn] = {EVAL_COM1_TX_SOURCE, EVAL_COM2_TX_SOURCE};

const uint16_t COM_RX_PIN_SOURCE[COMn] = {EVAL_COM1_RX_SOURCE, EVAL_COM2_RX_SOURCE};
 
const uint16_t COM_TX_AF[COMn] = {EVAL_COM1_TX_AF, EVAL_COM2_TX_AF};
 
const uint16_t COM_RX_AF[COMn] = {EVAL_COM1_RX_AF, EVAL_COM2_RX_AF};
#endif

int main(void)
{
  /*!< At this stage the microcontroller clock setting is already configured, 
       this is done through SystemInit() function which is called from startup
       file (startup_stm32f10x_xx.s) before to branch to application main.
       To reconfigure the default setting of SystemInit() function, refer to
       system_stm32f10x.c file
     */     


  /* USARTx configured as follow:
        - BaudRate = 115200 baud  
        - Word Length = 8 Bits
        - One Stop Bit
        - No parity
        - Hardware flow control disabled (RTS and CTS signals)
        - Receive and transmit enabled
  */

  int ch;
  
  USART_InitStructure.USART_BaudRate = 115200;
  USART_InitStructure.USART_WordLength = USART_WordLength_8b;
  USART_InitStructure.USART_StopBits = USART_StopBits_1;
  USART_InitStructure.USART_Parity = USART_Parity_No;
  USART_InitStructure.USART_HardwareFlowControl = USART_HardwareFlowControl_None;
  USART_InitStructure.USART_Mode = USART_Mode_Rx | USART_Mode_Tx;



  STM_EVAL_COMInit(COM1, &USART_InitStructure);

  /* Output a message on Hyperterminal using printf function */
  printf("\n\rUSART Printf Example: retarget the C library printf function to the USART\n\r");

  while (1)
  {

	if(GetKey_Received() == 1)
	{
		ch = GetKey();
		printf("%c\r\n", ch);
	}

	printf("Hello\r\n");
	
	
  /*
  	printf("Hello\r\n");
	ch=GetKey();
	printf("%c\r\n", ch);
*/
  }
}

/**
  * @brief  Retargets the C library printf function to the USART.
  * @param  None
  * @retval None
  */
PUTCHAR_PROTOTYPE
{
  /* Place your implementation of fputc here */
  /* e.g. write a character to the USART */
  USART_SendData(EVAL_COM1, (uint8_t) ch);

  /* Loop until the end of transmission */
  while (USART_GetFlagStatus(EVAL_COM1, USART_FLAG_TC) == RESET)
  {}

  return ch;
}

#ifdef  USE_FULL_ASSERT

/**
  * @brief  Reports the name of the source file and the source line number
  *         where the assert_param error has occurred.
  * @param  file: pointer to the source file name
  * @param  line: assert_param error line source number
  * @retval None
  */
void assert_failed(uint8_t* file, uint32_t line)
{ 
  /* User can add his own implementation to report the file name and line number,
     ex: printf("Wrong parameters value: file %s on line %d\r\n", file, line) */

  /* Infinite loop */
  while (1)
  {
  }
}

#endif

/**
  * @}
  */ 

/**
  * @}
  */ 

/******************* (C) COPYRIGHT 2011 STMicroelectronics *****END OF FILE****/
