riversnails/narsha_database/study/arm/STM32F407Z_open-407Z/Open407Z-C/ETH/STM32F4x7_ETH_LwIP_V1.0.0/Project/Standalone/httpserver/inc/main.h

/**
  ******************************************************************************
  * @file    main.h
  * @author  MCD Application Team
  * @version V1.0.0
  * @date    31-October-2011 
  * @brief   This file contains all the functions prototypes for the main.c 
  *          file.
  ******************************************************************************
  * @attention
  *
  * THE PRESENT FIRMWARE WHICH IS FOR GUIDANCE ONLY AIMS AT PROVIDING CUSTOMERS
  * WITH CODING INFORMATION REGARDING THEIR PRODUCTS IN ORDER FOR THEM TO SAVE
  * TIME. AS A RESULT, STMICROELECTRONICS SHALL NOT BE HELD LIABLE FOR ANY
  * DIRECT, INDIRECT OR CONSEQUENTIAL DAMAGES WITH RESPECT TO ANY CLAIMS ARISING
  * FROM THE CONTENT OF SUCH FIRMWARE AND/OR THE USE MADE BY CUSTOMERS OF THE
  * CODING INFORMATION CONTAINED HEREIN IN CONNECTION WITH THEIR PRODUCTS.
  *
  * <h2><center>&copy; COPYRIGHT 2011 STMicroelectronics</center></h2>
  ******************************************************************************
  */

/* Define to prevent recursive inclusion -------------------------------------*/
#ifndef __MAIN_H
#define __MAIN_H

#ifdef __cplusplus
 extern "C" {
#endif

/* Includes ------------------------------------------------------------------*/
#include "stm32f4xx.h"
#include "stm32f4x7_eth_bsp.h"

/* Exported types ------------------------------------------------------------*/
/* Exported constants --------------------------------------------------------*/

#define USE_LCD        /* enable LCD  */  
//#define USE_DHCP       /* enable DHCP, if disabled static address is used */
   
/* Uncomment SERIAL_DEBUG to enables retarget of printf to serial port (COM1 on STM32 evalboard) 
   for debug purpose */   
//#define SERIAL_DEBUG 

 
/* MAC ADDRESS: MAC_ADDR0:MAC_ADDR1:MAC_ADDR2:MAC_ADDR3:MAC_ADDR4:MAC_ADDR5 */
#define MAC_ADDR0   2
#define MAC_ADDR1   0
#define MAC_ADDR2   0
#define MAC_ADDR3   0
#define MAC_ADDR4   0
#define MAC_ADDR5   0
 
/*Static IP ADDRESS: IP_ADDR0.IP_ADDR1.IP_ADDR2.IP_ADDR3 */
#define IP_ADDR0   192
#define IP_ADDR1   168
#define IP_ADDR2   1
#define IP_ADDR3   10
   
/*NETMASK*/
#define NETMASK_ADDR0   255
#define NETMASK_ADDR1   255
#define NETMASK_ADDR2   255
#define NETMASK_ADDR3   0

/*Gateway Address*/
#define GW_ADDR0   192
#define GW_ADDR1   168
#define GW_ADDR2   1
#define GW_ADDR3   1  

/* MII and RMII mode selection, for STM324xG-EVAL Board(MB786) RevB ***********/
#define RMII_MODE  // User have to provide the 50 MHz clock by soldering a 50 MHz
                     // oscillator (ref SM7745HEV-50.0M or equivalent) on the U3
                     // footprint located under CN3 and also removing jumper on JP5. 
                     // This oscillator is not provided with the board. 
                     // For more details, please refer to STM3240G-EVAL evaluation
                     // board User manual (UM1461).

                                     
//#define MII_MODE

/* Uncomment the define below to clock the PHY from external 25MHz crystal (only for MII mode) */
#ifdef 	MII_MODE
 #define PHY_CLOCK_MCO
#endif

/* STM324xG-EVAL jumpers setting
    +==========================================================================================+
    +  Jumper |       MII mode configuration            |      RMII mode configuration         +
    +==========================================================================================+
    +  JP5    | 2-3 provide 25MHz clock by MCO(PA8)     |  Not fitted                          +
    +         | 1-2 provide 25MHz clock by ext. Crystal |                                      +
    + -----------------------------------------------------------------------------------------+
    +  JP6    |          2-3                            |  1-2                                 +
    + -----------------------------------------------------------------------------------------+
    +  JP8    |          Open                           |  Close                               +
    +==========================================================================================+
  */
   
/* Exported macro ------------------------------------------------------------*/
/* Exported functions ------------------------------------------------------- */  
void Time_Update(void);
void Delay(uint32_t nCount);


#ifdef __cplusplus
}
#endif

#endif /* __MAIN_H */


/******************* (C) COPYRIGHT 2011 STMicroelectronics *****END OF FILE****/
