riversnails/narsha_database/study/arm/STM32F407Z_open-407Z/Open407Z-C/ADC+DMA/User/main.c

/**
  ******************************************************************************
  * @file    main.c 
  * @author  MCD Application Team
  * @version V1.0.0
  * @date    18-April-2011
  * @brief   Main program body
  ******************************************************************************
  * @attention
  *
  * THE PRESENT FIRMWARE WHICH IS FOR GUIDANCE ONLY AIMS AT PROVIDING CUSTOMERS
  * WITH CODING INFORMATION REGARDING THEIR PRODUCTS IN ORDER FOR THEM TO SAVE
  * TIME. AS A RESULT, STMICROELECTRONICS SHALL NOT BE HELD LIABLE FOR ANY
  * DIRECT, INDIRECT OR CONSEQUENTIAL DAMAGES WITH RESPECT TO ANY CLAIMS ARISING
  * FROM THE CONTENT OF SUCH FIRMWARE AND/OR THE USE MADE BY CUSTOMERS OF THE
  * CODING INFORMATION CONTAINED HEREIN IN CONNECTION WITH THEIR PRODUCTS.
  *
  * <h2><center>&copy; COPYRIGHT 2011 STMicroelectronics</center></h2>
  ******************************************************************************  
  */ 

/* Includes ------------------------------------------------------------------*/
#include "stm32f4xx.h"
#include "usart.h"

/** @addtogroup STM32F2xx_StdPeriph_Examples
  * @{
  */

/** @addtogroup IOToggle
  * @{
  */ 

/* Private typedef -----------------------------------------------------------*/

void GPIO_Configuration(void);
void Delay(__IO uint32_t nCount);

/* Private define ------------------------------------------------------------*/
/* Private macro -------------------------------------------------------------*/
/* Private variables ---------------------------------------------------------*/
/* Private function prototypes -----------------------------------------------*/
/* Private functions ---------------------------------------------------------*/

/**
  * @brief  Main program
  * @param  None
  * @retval None				  
  */


/* Private define ------------------------------------------------------------*/
#define ADC1_DR_Address    ((u32)0x4001204C)
/* Private macro -------------------------------------------------------------*/
/* Private variables ---------------------------------------------------------*/

/* Private function prototypes -----------------------------------------------*/
void USART_Configuration(void);
void ADC_Configuration(void);

/* Private variables ---------------------------------------------------------*/
float AD_value_1,AD_value_2;
vu16 ADC_ConvertedValue[2];

void ADC1_CH6_DMA_Config(void);

int main(void)
{
	USART_Configuration();
	
	ADC1_CH6_DMA_Config();
	
	ADC_SoftwareStartConv(ADC1);

	while(1)
	{
		/* Printf message with AD value to serial port every 1 second */
		printf("\r\n****************************************************************\r\n");
		AD_value_1 = ADC_ConvertedValue[0];
		AD_value_1 = (AD_value_1/4096)*3.3;
		printf("The current AD1 value = %4.2fV \r\n", AD_value_1);
		
		AD_value_2 = ADC_ConvertedValue[1];
		AD_value_2 = (AD_value_2/4096)*3.3;
		printf("The current AD2 value = %4.2fV \r\n", AD_value_2);
		Delay(0x1ffffff); 
	}
}
void GPIO_Configuration(void)
{
	GPIO_InitTypeDef  GPIO_InitStructure;
    RCC_AHB1PeriphClockCmd(RCC_AHB1Periph_GPIOF, ENABLE);

	//LED1 (PC9)  LED2 (PC10)  LED3 (PC11)  LED4 (PC12)
    GPIO_InitStructure.GPIO_Pin = GPIO_Pin_6 | GPIO_Pin_7| GPIO_Pin_8| GPIO_Pin_9;
	GPIO_InitStructure.GPIO_Mode = GPIO_Mode_OUT;
	GPIO_InitStructure.GPIO_OType = GPIO_OType_PP;
	GPIO_InitStructure.GPIO_Speed = GPIO_Speed_100MHz;
	GPIO_InitStructure.GPIO_PuPd = GPIO_PuPd_NOPULL;
	GPIO_Init(GPIOF, &GPIO_InitStructure);	

}
/**
  * @brief  ADC1 channel6 with DMA configuration
  * @param  None
  * @retval None
  */
void ADC1_CH6_DMA_Config(void)
{
  ADC_InitTypeDef       ADC_InitStructure;
  ADC_CommonInitTypeDef ADC_CommonInitStructure;
  DMA_InitTypeDef       DMA_InitStructure;
  GPIO_InitTypeDef      GPIO_InitStructure;

  RCC_AHB1PeriphClockCmd(RCC_AHB1Periph_DMA2 | RCC_AHB1Periph_GPIOA, ENABLE);
  RCC_APB2PeriphClockCmd(RCC_APB2Periph_ADC1, ENABLE);

//  DMA_DeInit(DMA2_Stream0);
  /* DMA2 Stream0 channe0 configuration **************************************/
  DMA_InitStructure.DMA_Channel = DMA_Channel_0;  
  DMA_InitStructure.DMA_PeripheralBaseAddr = (uint32_t)ADC1_DR_Address;
  DMA_InitStructure.DMA_Memory0BaseAddr = (uint32_t)&ADC_ConvertedValue;
  DMA_InitStructure.DMA_DIR = DMA_DIR_PeripheralToMemory;
  DMA_InitStructure.DMA_BufferSize = 2;
  DMA_InitStructure.DMA_PeripheralInc = DMA_PeripheralInc_Disable;
  DMA_InitStructure.DMA_MemoryInc = DMA_MemoryInc_Enable;
  DMA_InitStructure.DMA_PeripheralDataSize = DMA_PeripheralDataSize_HalfWord;
  DMA_InitStructure.DMA_MemoryDataSize = DMA_MemoryDataSize_HalfWord;
  DMA_InitStructure.DMA_Mode = DMA_Mode_Circular;
  DMA_InitStructure.DMA_Priority = DMA_Priority_High;
  DMA_InitStructure.DMA_FIFOMode = DMA_FIFOMode_Disable;         
  DMA_InitStructure.DMA_FIFOThreshold = DMA_FIFOThreshold_HalfFull;
  DMA_InitStructure.DMA_MemoryBurst = DMA_MemoryBurst_Single;
  DMA_InitStructure.DMA_PeripheralBurst = DMA_PeripheralBurst_Single;
  DMA_Init(DMA2_Stream0, &DMA_InitStructure);
  DMA_Cmd(DMA2_Stream0, ENABLE);

  /* Configure ADC1 Channel6 pin as analog input ******************************/
  GPIO_InitStructure.GPIO_Pin = GPIO_Pin_6 | GPIO_Pin_7;
  GPIO_InitStructure.GPIO_Mode = GPIO_Mode_AN;
  GPIO_InitStructure.GPIO_PuPd = GPIO_PuPd_NOPULL ;
  GPIO_Init(GPIOA, &GPIO_InitStructure);

  /* ADC Common Init **********************************************************/
  ADC_CommonInitStructure.ADC_Mode = ADC_Mode_Independent;
  ADC_CommonInitStructure.ADC_Prescaler = ADC_Prescaler_Div2;
  ADC_CommonInitStructure.ADC_DMAAccessMode = ADC_DMAAccessMode_Disabled;
  ADC_CommonInitStructure.ADC_TwoSamplingDelay = ADC_TwoSamplingDelay_5Cycles;
  ADC_CommonInit(&ADC_CommonInitStructure);

  /* ADC1 Init ****************************************************************/
  ADC_InitStructure.ADC_Resolution = ADC_Resolution_12b;
  ADC_InitStructure.ADC_ScanConvMode = ENABLE;
  ADC_InitStructure.ADC_ContinuousConvMode = ENABLE;
  ADC_InitStructure.ADC_ExternalTrigConvEdge = ADC_ExternalTrigConvEdge_None;
  ADC_InitStructure.ADC_DataAlign = ADC_DataAlign_Right;
  ADC_InitStructure.ADC_NbrOfConversion = 2;
  ADC_Init(ADC1, &ADC_InitStructure);

  /* ADC1 regular channe6 configuration *************************************/
  ADC_RegularChannelConfig(ADC1, ADC_Channel_6, 1, ADC_SampleTime_3Cycles);
  ADC_RegularChannelConfig(ADC1, ADC_Channel_7, 2, ADC_SampleTime_3Cycles);
 /* Enable DMA request after last transfer (Single-ADC mode) */
  ADC_DMARequestAfterLastTransferCmd(ADC1, ENABLE);

  /* Enable ADC3 DMA */
  ADC_DMACmd(ADC1, ENABLE);

  /* Enable ADC3 */
  ADC_Cmd(ADC1, ENABLE);

}


/**
  * @brief  Delay Function.
  * @param  nCount:specifies the Delay time length.
  * @retval None
  */
void Delay(__IO uint32_t nCount)
{
  while(nCount--)
  {

  }
}

#ifdef  USE_FULL_ASSERT

/**
  * @brief  Reports the name of the source file and the source line number
  *         where the assert_param error has occurred.
  * @param  file: pointer to the source file name
  * @param  line: assert_param error line source number
  * @retval None
  */
void assert_failed(uint8_t* file, uint32_t line)
{ 
  /* User can add his own implementation to report the file name and line number,
     ex: printf("Wrong parameters value: file %s on line %d\r\n", file, line) */

  /* Infinite loop */
  while (1)
  {

  }
}
#endif

/**
  * @}
  */ 

/**
  * @}
  */ 

/******************* (C) COPYRIGHT 2011 STMicroelectronics *****END OF FILE****/
