riversnails/narsha_database/study/avr/arduino/oled_color_128_128_lib/oled_color_128_128_lib/oled_color_128_128_lib.ino

#include "OLED_Driver.h"
#include "OLED_GFX.h"

#include <SPI.h>
#include <Wire.h>

OLED_GFX oled = OLED_GFX();

void setup()  {

  //Init GPIO
  //pinMode(53, OUTPUT);
  pinMode(10, OUTPUT);
  
  pinMode(oled_cs, OUTPUT);
  pinMode(oled_rst, OUTPUT);
  pinMode(oled_dc, OUTPUT);

  pinMode(oled_sck, OUTPUT);
  pinMode(oled_din, OUTPUT);


  //Init UART
  Serial.begin(115200);

#if INTERFACE_4WIRE_SPI
  //Init SPI
  SPI.setDataMode(SPI_MODE0);
  SPI.setBitOrder(MSBFIRST);
  SPI.setClockDivider(SPI_CLOCK_DIV2);
  SPI.begin();

#elif INTERFACE_3WIRE_SPI

  pinMode(oled_sck, OUTPUT);
  pinMode(oled_din, OUTPUT);

#endif

  oled.Device_Init();
  
  oled.Display_Interface();
  delay(3000);

  oled.Clear_Screen();

  oled.Set_Color(BLUE);
  oled.print_String(20, 50, "Hello WaveShare !", FONT_5X8);
  delay(2000);
  oled.Clear_Screen();

  oled.Set_Color(WHITE);
  oled.Draw_Pixel(50,50);
  delay(1000);

  lcdTestPattern();
  delay(1000);

  testlines();
  delay(1000);
  
  testfastlines();
  delay(1000);

  testdrawrects();
  delay(1000);

  testfillrects(BLUE,YELLOW);
  delay(1000);


  oled.Clear_Screen();
  testfillcircles(63, BLUE);
  delay(500);
  testdrawcircles(WHITE);
  delay(1000);
  
  testroundrects();
  delay(1000);
  
  testtriangles();
  delay(1000);

 // oled.Fill_Color(BLUE);

  
}


void loop() {

}


void testlines(void)  {

  oled.Set_Color(RED);
  oled.Clear_Screen();
  for (uint16_t x=0; x <= SSD1351_WIDTH - 1; x+=6)  {
    oled.Draw_Line(0, 0, x, SSD1351_HEIGHT - 1);
    delay(10);
  }
  for (uint16_t y=0; y < SSD1351_HEIGHT - 1; y+=6)  {
    oled.Draw_Line(0, 0, SSD1351_WIDTH - 1, y);
    delay(10);
  }
  
  oled.Set_Color(YELLOW);
  oled.Clear_Screen();
  for (uint16_t x=0; x < SSD1351_WIDTH - 1; x+=6) {
    oled.Draw_Line(SSD1351_WIDTH - 1, 0, x, SSD1351_HEIGHT - 1);
    delay(10);
  }
  for (uint16_t y=0; y < SSD1351_HEIGHT - 1; y+=6) {
    oled.Draw_Line(SSD1351_WIDTH - 1, 0, 0, y);
    delay(10);
  }
   
  oled.Set_Color(BLUE);
  oled.Clear_Screen();
  for (uint16_t x=0; x < SSD1351_WIDTH - 1; x+=6) {
    oled.Draw_Line(0, SSD1351_HEIGHT - 1, x, 0);
    delay(10);
  }
  for (uint16_t y=0; y < SSD1351_HEIGHT - 1; y+=6) {
    oled.Draw_Line(0, SSD1351_HEIGHT - 1, SSD1351_WIDTH - 1, y);
    delay(10);
  }

  oled.Set_Color(GREEN);
  oled.Clear_Screen();
  for (uint16_t x=0; x < SSD1351_WIDTH - 1; x+=6) {
  oled.Draw_Line(SSD1351_WIDTH - 1, SSD1351_HEIGHT - 1, x, 0 );
    delay(10);
  }
  for (uint16_t y=0; y < SSD1351_HEIGHT - 1; y+=6) {
    oled.Draw_Line(SSD1351_WIDTH - 1, SSD1351_HEIGHT - 1, 0, y);
    delay(10);
  }
}

void lcdTestPattern(void)
{
  uint32_t i,j;
  oled.Set_Coordinate(0, 0);
  
  for(i=0;i<128;i++)  {
    for(j=0;j<128;j++)  {
      if(i<16)  {
        oled.Set_Color(RED);
        oled.Write_Data(color_byte[0]);
        oled.Write_Data(color_byte[1]);
      }
      else if(i<32) {
        oled.Set_Color(YELLOW);
        oled.Write_Data(color_byte[0]);
        oled.Write_Data(color_byte[1]);
      }
      else if(i<48) {
        oled.Set_Color(GREEN);
        oled.Write_Data(color_byte[0]);
        oled.Write_Data(color_byte[1]);
      }
      else if(i<64) {
        oled.Set_Color(CYAN);
        oled.Write_Data(color_byte[0]);
        oled.Write_Data(color_byte[1]);
      }
      else if(i<80) {
        oled.Set_Color(BLUE);
        oled.Write_Data(color_byte[0]);
        oled.Write_Data(color_byte[1]);
      }
      else if(i<96) {
        oled.Set_Color(MAGENTA);
        oled.Write_Data(color_byte[0]);
        oled.Write_Data(color_byte[1]);
      }
      else if(i<112)  {
        oled.Set_Color(BLACK);
        oled.Write_Data(color_byte[0]);
        oled.Write_Data(color_byte[1]);
      }
      else {
        oled.Set_Color(WHITE);
        oled.Write_Data(color_byte[0]);
        oled.Write_Data(color_byte[1]);
      }
    }
  }
}

void testfastlines(void) {
  
  oled.Set_Color(WHITE);
  oled.Clear_Screen();
  
  for (uint16_t y=0; y < SSD1351_WIDTH - 1; y+=5) {
    oled.Draw_FastHLine(0, y, SSD1351_WIDTH - 1);
    delay(10);
  }
  for (uint16_t x=0; x < SSD1351_HEIGHT - 1; x+=5) {
    oled.Draw_FastVLine(x, 0, SSD1351_HEIGHT - 1);
    delay(10);
  }
}

void testdrawrects(void)  {
  oled.Clear_Screen();
  for (uint16_t x=0; x < SSD1351_HEIGHT - 1; x+=6)  {
    oled.Draw_Rect((SSD1351_WIDTH-1)/2 - x/2, (SSD1351_HEIGHT-1)/2 - x/2 , x, x);
    delay(10);
  }
}

void testfillrects(uint16_t color1, uint16_t color2)  {
  
  uint16_t x = SSD1351_HEIGHT - 1;
  oled.Clear_Screen();
  oled.Set_Color(color1);
  oled.Set_FillColor(color2);
  for(; x > 6; x-=6)  {
    oled.Fill_Rect((SSD1351_WIDTH-1)/2 - x/2, (SSD1351_HEIGHT-1)/2 - x/2 , x, x);
  oled.Draw_Rect((SSD1351_WIDTH-1)/2 - x/2, (SSD1351_HEIGHT-1)/2 - x/2 , x, x);
  }
}

void testfillcircles(uint8_t radius, uint16_t color)  {
  
  oled.Set_Color(color);

  oled.Fill_Circle(64, 64, radius);
  }


void testdrawcircles(uint16_t color)  {
  
  uint8_t r = 0;
  oled.Set_Color(color);
  
  for (; r < SSD1351_WIDTH/2; r+=4)  {
    oled.Draw_Circle(64, 64, r);
    delay(10);
  }
}

void testroundrects(void) {

  int color = 100;
  int x = 0, y = 0;
  int w = SSD1351_WIDTH - 1, h = SSD1351_HEIGHT - 1;
  
  oled.Clear_Screen();
  
  for(int i = 0 ; i <= 20; i++) {

    oled.Draw_RoundRect(x, y, w, h, 5);
    x += 2;
    y += 3;
    w -= 4;
    h -= 6;
    color += 1100;
    oled.Set_Color(color);
  }
}

void testtriangles(void)  {
  oled.Clear_Screen();
  int color = 0xF800;
  int t;
  int w = SSD1351_WIDTH/2;
  int x = SSD1351_HEIGHT-1;
  int y = 0;
  int z = SSD1351_WIDTH;
  for(t = 0 ; t <= 15; t+=1) {
    oled.Draw_Triangle(w, y, y, x, z, x);
    x-=4;
    y+=4;
    z-=4;
    color+=100;
    oled.Set_Color(color);
  }
}
