riversnails/narsha_database/study/arm/STM32F407Z_open-407Z/Open407Z-C/NRF24L01/User/NRF24L01/NRF24L01.h

#ifndef _NRF24L01_H
#define _NRF24L01_H

#define Open_SPIx                           SPI1

#define Open_SPIx_CLK                       RCC_APB2Periph_SPI1
#define Open_SPIx_IRQn                      SPI1_IRQn
#define Open_SPIx_IRQHANDLER                SPI1_IRQHandler

#define Open_SPIx_SCK_PIN                   GPIO_Pin_5
#define Open_SPIx_SCK_GPIO_PORT             GPIOA
#define Open_SPIx_SCK_GPIO_CLK              RCC_AHB1Periph_GPIOA
#define Open_SPIx_SCK_SOURCE                GPIO_PinSource5
#define Open_SPIx_SCK_AF                    GPIO_AF_SPI1

#define Open_SPIx_MISO_PIN                  GPIO_Pin_6
#define Open_SPIx_MISO_GPIO_PORT            GPIOA
#define Open_SPIx_MISO_GPIO_CLK             RCC_AHB1Periph_GPIOA
#define Open_SPIx_MISO_SOURCE               GPIO_PinSource6
#define Open_SPIx_MISO_AF                   GPIO_AF_SPI1

#define Open_SPIx_MOSI_PIN                  GPIO_Pin_7
#define Open_SPIx_MOSI_GPIO_PORT            GPIOA
#define Open_SPIx_MOSI_GPIO_CLK             RCC_AHB1Periph_GPIOA
#define Open_SPIx_MOSI_SOURCE               GPIO_PinSource7
#define Open_SPIx_MOSI_AF                   GPIO_AF_SPI1

/**
 * @connected to NRF24L01
 */
 /* Configure NRF24L01 pins: IRQ->PB14 and CSN->PB15  CE->PB13*/ 
 /*--------------------LED-----------------------------*/
#define Open_IRQ_GPIO_CLK							RCC_AHB1Periph_GPIOB
#define Open_IRQ_GPIO								GPIOB
#define Open_GPIO_Pin_IRQ							GPIO_Pin_14


#define Open_CSN_GPIO_CLK							RCC_AHB1Periph_GPIOB
#define Open_CSN_GPIO								GPIOB
#define Open_GPIO_Pin_CSN							GPIO_Pin_15

#define Open_CE_GPIO_CLK							RCC_AHB1Periph_GPIOB
#define Open_CE_GPIO								GPIOB
#define Open_GPIO_Pin_CE							GPIO_Pin_13

// CE Pin & CSN Pin & IRQ Pin
 /* Configure NRF24L01 pins: IRQ->PB14 and CSN->PB15  CE->PB13*/ 
#define CE(x)					x ? GPIO_SetBits(GPIOB,GPIO_Pin_13) : GPIO_ResetBits(GPIOB,GPIO_Pin_13);
#define CSN(x)					x ? GPIO_SetBits(GPIOB,GPIO_Pin_15) : GPIO_ResetBits(GPIOB,GPIO_Pin_15);
#define IRQ					    (GPIO_ReadInputDataBit(GPIOB,GPIO_Pin_14))


// SPI(nRF24L01) commands
#define READ_REG_NRF24L01    	0x00 				// Define read command to register
#define WRITE_REG_NRF24L01   	0x20 				// Define write command to register
#define RD_RX_PLOAD 			0x61 				// Define RX payload register address
#define WR_TX_PLOAD 			0xA0 				// Define TX payload register address
#define FLUSH_TX    			0xE1 				// Define flush TX register command
#define FLUSH_RX    			0xE2 				// Define flush RX register command
#define REUSE_TX_PL 			0xE3 				// Define reuse TX payload register command
#define NOP         			0xFF 				// Define No Operation, might be used to read status register
//***************************************************//
// SPI(nRF24L01) registers(addresses)
#define CONFIG      			0x00				// 'Config' register address
#define EN_AA       			0x01                		// 'Enable Auto Acknowledgment' register address
#define EN_RXADDR   			0x02                		// 'Enabled RX addresses' register address
#define SETUP_AW    			0x03                		// 'Setup address width' register address
#define SETUP_RETR  			0x04                		// 'Setup Auto. Retrans' register address
#define RF_CH       			0x05                		// 'RF channel' register address
#define RF_SETUP    			0x06 				// 'RF setup' register address
#define STATUS      			0x07 				// 'Status' register address
#define OBSERVE_TX  			0x08 				// 'Observe TX' register address
#define CD          			0x09 				//'Carrier Detect' register address
#define RX_ADDR_P0  			0x0A				// 'RX address pipe0' register address
#define RX_ADDR_P1  			0x0B 				// 'RX address pipe1' register address
#define RX_ADDR_P2  			0x0C 				// 'RX address pipe2' register address
#define RX_ADDR_P3  			0x0D 				// 'RX address pipe3' register address
#define RX_ADDR_P4  			0x0E 				// 'RX address pipe4' register address
#define RX_ADDR_P5  			0x0F				// 'RX address pipe5' register address
#define TX_ADDR     			0x10 				// 'TX address' register address
#define RX_PW_P0    			0x11 				// 'RX payload width, pipe0' register address
#define RX_PW_P1    			0x12 				// 'RX payload width, pipe1' register address
#define RX_PW_P2    			0x13 				// 'RX payload width, pipe2' register address
#define RX_PW_P3    			0x14 				// 'RX payload width, pipe3' register address
#define RX_PW_P4    			0x15 				// 'RX payload width, pipe4' register address
#define RX_PW_P5    			0x16 				// 'RX payload width, pipe5' register address
#define FIFO_STATUS 			0x17 			    	// 'FIFO Status Register' register address

#define TX_ADR_WIDTH   	5  // 5字节宽度的发送/接收地址
#define TX_PLOAD_WIDTH 	32  // 数据通道有效数据宽度

u8 SPI_Write_Reg(u8 reg,u8 value);
u8 SPI_Read_Reg(u8 reg);
u8 SPI_Read_Buf(u8 reg,u8 *pBuf,u8 bytes);
u8 SPI_Write_Buf(u8 reg,u8 *pBuf,u8 bytes);
u8 nRF24L01_RxPacket(unsigned char *rx_buf);
void nRF24L01_TxPacket(unsigned char *tx_buf);
void RX_Mode(void);
void TX_Mode(u8 * tx_buf);
void nRF24L01_Initial(void);
void nRF24L01_Config(void);
void NRF24L01_Send(void);
void NRF24L01_Receive(void);

#endif /*_NRF24L01_H*/
