riversnails/narsha_database/study/avr/arduino/control/main1.c

/********************************************************
File name:       main1.c
File size:       16454
Convertion date: 2020-12-07-월 오전 10:02:12

File generated using DisplayModule's Image Converter
********************************************************/

#if defined (__AVR__)
  #include <avr/pgmspace.h>
  const prog_uchar main1[0x4046] PROGMEM ={
#else
  const unsigned char main1[0x4046] PROGMEM ={
#endif

  0x42, 0x4D, 0x46, 0x40, 0x0, 0x0, 0x0, 0x0, 0x0, 0x0, 0x46, 0x0, 0x0, 0x0, 0x38, 0x0, 0x0, 0x0, 0x80, 0x0, 0x0, 0x0, 0xC0, 0xFF, 0xFF, 0xFF, 0x1, 0x0, 0x10, 0x0, 0x3, 0x0, 
  0x0, 0x0, 0x0, 0x40, 0x0, 0x0, 0x0, 0x0, 0x0, 0x0, 0x0, 0x0, 0x0, 0x0, 0x0, 0x0, 0x0, 0x0, 0x0, 0x0, 0x0, 0x0, 0x0, 0xF8, 0x0, 0x0, 0xE0, 0x7, 0x0, 0x0, 0x1F, 0x0, 
  0x0, 0x0, 0x0, 0x0, 0x0, 0x0, 0x41, 0x8, 0xF3, 0x9C, 0xFF, 0xFF, 0xFF, 0xFF, 0xFF, 0xFF, 0xFF, 0xFF, 0xFF, 0xFF, 0xFF, 0xFF, 0xFF, 0xFF, 0xFF, 0xFF, 0xFF, 0xFF, 0xFF, 0xFF, 0xFF, 0xFF, 
  0xFF, 0xFF, 0xFF, 0xFF, 0xFF, 0xFF, 0xFF, 0xFF, 0xFF, 0xFF, 0xFF, 0xFF, 0xFF, 0xFF, 0xFF, 0xFF, 0xFF, 0xFF, 0xFF, 0xFF, 0xFF, 0xFF, 0xFF, 0xFF, 0xFF, 0xFF, 0xFF, 0xFF, 0xFF, 0xFF, 0xFF, 0xFF, 
  0xFF, 0xFF, 0xFF, 0xFF, 0xFF, 0xFF, 0xFF, 0xFF, 0xFF, 0xFF, 0xFF, 0xFF, 0xFF, 0xFF, 0xFF, 0xFF, 0xFF, 0xFF, 0xFF, 0xFF, 0xFF, 0xFF, 0xFF, 0xFF, 0xFF, 0xFF, 0xFF, 0xFF, 0xFF, 0xFF, 0xFF, 0xFF, 
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
  0xFF, 0xFF, 0xFF, 0xFF, 0xFF, 0xFF, 0xFF, 0xFF, 0xFF, 0xFF, 0xFF, 0xFF, 0xFF, 0xFF, 0xFF, 0xFF, 0xFF, 0xFF, 0xFF, 0xFF, 0xFF, 0xFF, 0xFF, 0xFF, 0xFF, 0xFF, 0xFF, 0xFF, 0xFF, 0xFF, 0xFF, 0xFF, 
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
};
