riversnails/narsha_database/study/arm/MangoM32F2-Manual-Source/Source/mango-m32f2_120612_1731_usbdev-vcp/src/httpserver/src/fsdata.c

#include "fs.h"
#include "lwip/def.h"
#include "fsdata.h"


#define file_NULL (struct fsdata_file *) NULL


static const unsigned int dummy_align__STM32F2x7_files_logo_jpg = 0;
static const unsigned char data__STM32F2x7_files_logo_jpg[] = {
/* /STM32F2x7_files/logo.jpg (26 chars) */
0x2f,0x53,0x54,0x4d,0x33,0x32,0x46,0x32,0x78,0x37,0x5f,0x66,0x69,0x6c,0x65,0x73,
0x2f,0x6c,0x6f,0x67,0x6f,0x2e,0x6a,0x70,0x67,0x00,0x00,0x00,

/* HTTP header */
/* "HTTP/1.0 200 OK
" (17 bytes) */
0x48,0x54,0x54,0x50,0x2f,0x31,0x2e,0x30,0x20,0x32,0x30,0x30,0x20,0x4f,0x4b,0x0d,
0x0a,
/* "Server: lwIP/1.3.1 (http://savannah.nongnu.org/projects/lwip)
" (63 bytes) */
0x53,0x65,0x72,0x76,0x65,0x72,0x3a,0x20,0x6c,0x77,0x49,0x50,0x2f,0x31,0x2e,0x33,
0x2e,0x31,0x20,0x28,0x68,0x74,0x74,0x70,0x3a,0x2f,0x2f,0x73,0x61,0x76,0x61,0x6e,
0x6e,0x61,0x68,0x2e,0x6e,0x6f,0x6e,0x67,0x6e,0x75,0x2e,0x6f,0x72,0x67,0x2f,0x70,
0x72,0x6f,0x6a,0x65,0x63,0x74,0x73,0x2f,0x6c,0x77,0x69,0x70,0x29,0x0d,0x0a,
/* "Content-type: image/jpeg

" (28 bytes) */
0x43,0x6f,0x6e,0x74,0x65,0x6e,0x74,0x2d,0x74,0x79,0x70,0x65,0x3a,0x20,0x69,0x6d,
0x61,0x67,0x65,0x2f,0x6a,0x70,0x65,0x67,0x0d,0x0a,0x0d,0x0a,
/* raw file data (3023 bytes) */
0xff,0xd8,0xff,0xe0,0x00,0x10,0x4a,0x46,0x49,0x46,0x00,0x01,0x01,0x01,0x01,0x2c,
0x01,0x2c,0x00,0x00,0xff,0xe1,0x00,0x68,0x45,0x78,0x69,0x66,0x00,0x00,0x49,0x49,
0x2a,0x00,0x08,0x00,0x00,0x00,0x04,0x00,0x1a,0x01,0x05,0x00,0x01,0x00,0x00,0x00,
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
0x73,0x20,0x63,0x6f,0x6e,0x74,0x72,0x6f,0x6c,0x3c,0x2f,0x73,0x70,0x61,0x6e,0x3e,
0x3c,0x2f,0x73,0x74,0x72,0x6f,0x6e,0x67,0x3e,0x26,0x6e,0x62,0x73,0x70,0x3b,0x0d,
0x0a,0x26,0x6e,0x62,0x73,0x70,0x3b,0x20,0x26,0x6e,0x62,0x73,0x70,0x3b,0x20,0x26,
0x6e,0x62,0x73,0x70,0x3b,0x20,0x26,0x6e,0x62,0x73,0x70,0x3b,0x26,0x6e,0x62,0x73,
0x70,0x3b,0x3c,0x2f,0x62,0x69,0x67,0x3e,0x3c,0x2f,0x62,0x69,0x67,0x3e,0x3c,0x2f,
0x62,0x69,0x67,0x3e,0x3c,0x2f,0x62,0x69,0x67,0x3e,0x3c,0x2f,0x73,0x6d,0x61,0x6c,
0x6c,0x3e,0x3c,0x2f,0x73,0x6d,0x61,0x6c,0x6c,0x3e,0x3c,0x2f,0x68,0x34,0x3e,0x0d,
0x0a,0x3c,0x68,0x72,0x20,0x73,0x74,0x79,0x6c,0x65,0x3d,0x22,0x77,0x69,0x64,0x74,
0x68,0x3a,0x20,0x31,0x30,0x30,0x25,0x3b,0x20,0x68,0x65,0x69,0x67,0x68,0x74,0x3a,
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



const struct fsdata_file file__STM32F2x7_files_logo_jpg[] = { {
file_NULL,
data__STM32F2x7_files_logo_jpg,
data__STM32F2x7_files_logo_jpg + 28,
sizeof(data__STM32F2x7_files_logo_jpg) - 28,
1,
}};

const struct fsdata_file file__STM32F2x7_files_ST_gif[] = { {
file__STM32F2x7_files_logo_jpg,
data__STM32F2x7_files_ST_gif,
data__STM32F2x7_files_ST_gif + 24,
sizeof(data__STM32F2x7_files_ST_gif) - 24,
1,
}};

const struct fsdata_file file__STM32F2x7_files_stm32_jpeg[] = { {
file__STM32F2x7_files_ST_gif,
data__STM32F2x7_files_stm32_jpeg,
data__STM32F2x7_files_stm32_jpeg + 28,
sizeof(data__STM32F2x7_files_stm32_jpeg) - 28,
1,
}};

const struct fsdata_file file__404_html[] = { {
file__STM32F2x7_files_stm32_jpeg,
data__404_html,
data__404_html + 12,
sizeof(data__404_html) - 12,
1,
}};

const struct fsdata_file file__index_html[] = { {
file__404_html,
data__index_html,
data__index_html + 12,
sizeof(data__index_html) - 12,
1,
}};

const struct fsdata_file file__STM32F2x7ADC_shtml[] = { {
file__index_html,
data__STM32F2x7ADC_shtml,
data__STM32F2x7ADC_shtml + 20,
sizeof(data__STM32F2x7ADC_shtml) - 20,
1,
}};

const struct fsdata_file file__STM32F2x7LED_html[] = { {
file__STM32F2x7ADC_shtml,
data__STM32F2x7LED_html,
data__STM32F2x7LED_html + 20,
sizeof(data__STM32F2x7LED_html) - 20,
1,
}};

#define FS_ROOT file__STM32F2x7LED_html
#define FS_NUMFILES 7
