riversnails/narsha_database/study/arm/lecture/SPI/FW_Projects/STM32F103/Driver/src/flash.c

#include "flash.h" 
#include "spi.h"
#include "delay.h"   


//4Kbytes为一个Sector
//16个扇区为1个Block
//W25X16
//容量为2M字节,共有32个Block,512个Sector 

//初始化SPI FLASH的IO口
void SPI_Flash_Init(void)
{
	SPIx_Init();		   //初始化SPI
}  

//读取SPI_FLASH的状态寄存器
//BIT7  6   5   4   3   2   1   0
//SPR   RV  TB BP2 BP1 BP0 WEL BUSY
//SPR:默认0,状态寄存器保护位,配合WP使用
//TB,BP2,BP1,BP0:FLASH区域写保护设置
//WEL:写使能锁定
//BUSY:忙标记位(1,忙;0,空闲)
//默认:0x00
u8 SPI_Flash_ReadSR(void)   
{  
	u8 byte=0;   
	SPI_FLASH_CS=0;                            //使能器件   
	SPIx_ReadWriteByte(W25X_ReadStatusReg);    //发送读取状态寄存器命令    
	byte=SPIx_ReadWriteByte(0Xff);             //读取一个字节  
	SPI_FLASH_CS=1;                            //取消片选     
	return byte;   
} 
//写SPI_FLASH状态寄存器
//只有SPR,TB,BP2,BP1,BP0(bit 7,5,4,3,2)可以写!!!
void SPI_FLASH_Write_SR(u8 sr)   
{   
	SPI_FLASH_CS=0;                            //使能器件   
	SPIx_ReadWriteByte(W25X_WriteStatusReg);   //发送写取状态寄存器命令    
	SPIx_ReadWriteByte(sr);               //写入一个字节  
	SPI_FLASH_CS=1;                            //取消片选     	      
}   
//SPI_FLASH写使能	
//将WEL置位   
void SPI_FLASH_Write_Enable(void)   
{
	SPI_FLASH_CS=0;                            //使能器件   
    SPIx_ReadWriteByte(W25X_WriteEnable);      //发送写使能  
	SPI_FLASH_CS=1;                            //取消片选     	      
} 
//SPI_FLASH写禁止	
//将WEL清零  
void SPI_FLASH_Write_Disable(void)   
{  
	SPI_FLASH_CS=0;                            //使能器件   
    SPIx_ReadWriteByte(W25X_WriteDisable);     //发送写禁止指令    
	SPI_FLASH_CS=1;                            //取消片选     	      
} 			    
//读取芯片ID W25X16的ID:0XEF14
u16 SPI_Flash_ReadID(void)
{
	u16 Temp = 0;	  
	SPI_FLASH_CS=0;				    
	SPIx_ReadWriteByte(0x90);//发送读取ID命令	    
	SPIx_ReadWriteByte(0x00); 	    
	SPIx_ReadWriteByte(0x00); 	    
	SPIx_ReadWriteByte(0x00); 	 			   
	Temp|=SPIx_ReadWriteByte(0xFF)<<8;  
	Temp|=SPIx_ReadWriteByte(0xFF);	 
	SPI_FLASH_CS=1;				    
	return Temp;
}   		    
//读取SPI FLASH  
//在指定地址开始读取指定长度的数据
//pBuffer:数据存储区
//ReadAddr:开始读取的地址(24bit)
//NumByteToRead:要读取的字节数(最大65535)
void SPI_Flash_Read(u8* pBuffer,u32 ReadAddr,u16 NumByteToRead)   
{ 
 	u16 i;    												    
	SPI_FLASH_CS=0;                            //使能器件   
    SPIx_ReadWriteByte(W25X_ReadData);         //发送读取命令   
    SPIx_ReadWriteByte((u8)((ReadAddr)>>16));  //发送24bit地址    
    SPIx_ReadWriteByte((u8)((ReadAddr)>>8));   
    SPIx_ReadWriteByte((u8)ReadAddr);   
    for(i=0;i<NumByteToRead;i++)
	{ 
        pBuffer[i]=SPIx_ReadWriteByte(0XFF);   //循环读数  
    }
	SPI_FLASH_CS=1;                            //取消片选     	      
}  
//SPI在一页(0~65535)内写入少于256个字节的数据
//在指定地址开始写入最大256字节的数据
//pBuffer:数据存储区
//WriteAddr:开始写入的地址(24bit)
//NumByteToWrite:要写入的字节数(最大256),该数不应该超过该页的剩余字节数!!!	 
void SPI_Flash_Write_Page(u8* pBuffer,u32 WriteAddr,u16 NumByteToWrite)
{
 	u16 i;  
    SPI_FLASH_Write_Enable();                  //SET WEL 
	SPI_FLASH_CS=0;                            //使能器件   
    SPIx_ReadWriteByte(W25X_PageProgram);      //发送写页命令   
    SPIx_ReadWriteByte((u8)((WriteAddr)>>16)); //发送24bit地址    
    SPIx_ReadWriteByte((u8)((WriteAddr)>>8));   
    SPIx_ReadWriteByte((u8)WriteAddr);   
    for(i=0;i<NumByteToWrite;i++)SPIx_ReadWriteByte(pBuffer[i]);//循环写数  
	SPI_FLASH_CS=1;                            //取消片选 
	SPI_Flash_Wait_Busy();					   //等待写入结束
} 
//无检验写SPI FLASH 
//必须确保所写的地址范围内的数据全部为0XFF,否则在非0XFF处写入的数据将失败!
//具有自动换页功能 
//在指定地址开始写入指定长度的数据,但是要确保地址不越界!
//pBuffer:数据存储区
//WriteAddr:开始写入的地址(24bit)
//NumByteToWrite:要写入的字节数(最大65535)
//CHECK OK
void SPI_Flash_Write_NoCheck(u8* pBuffer,u32 WriteAddr,u16 NumByteToWrite)   
{ 			 		 
	u16 pageremain;	   
	pageremain=256-WriteAddr%256; //单页剩余的字节数		 	    
	if(NumByteToWrite<=pageremain)pageremain=NumByteToWrite;//不大于256个字节
	while(1)
	{	   
		SPI_Flash_Write_Page(pBuffer,WriteAddr,pageremain);
		if(NumByteToWrite==pageremain)break;//写入结束了
	 	else //NumByteToWrite>pageremain
		{
			pBuffer+=pageremain;
			WriteAddr+=pageremain;	

			NumByteToWrite-=pageremain;			  //减去已经写入了的字节数
			if(NumByteToWrite>256)pageremain=256; //一次可以写入256个字节
			else pageremain=NumByteToWrite; 	  //不够256个字节了
		}
	};	    
}
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
