riversnails/narsha_database/(commit log)

2020-08-18 Update 임베 수행평가.c
2020-08-18 Revert "Update 임베 수행평가.c"
    This reverts commit c983130f5bbc548c0643fb16fcbe0cc3adc3ef87.
2020-09-14 arduino remocon & ultrasonic
2020-09-14 arduino lcd
2020-09-28 document_add
    arduino servo
2020-09-28 document_add
    servo_micros
2020-09-28 document_add
    servo_micro_many
2020-10-05 arduino fnd
2020-10-12 arduino adc
2020-10-25 add custom_printer code
    add schematic & code
2020-10-26 arduino backup
2020-10-26 arduino keymatrix
2020-11-10 cutom printerrrrrrrr
2021-03-10 stm32
    regster test
2021-03-17 timer
    study timer and register
2021-03-17 timer
    make servo pwm
2021-03-18 timer
    cmpa timer, uie timer
2021-03-18 timer
    ultrasonic, pwm led
2021-03-24 dma, adc
2021-03-25 dma, adc
    joystick
2021-04-07 stm23f2xx
    lib add
    [simulation.xls]
2021-04-08 stm32f2xx
    buzzer
2021-04-14 rotary switch
2021-04-15 rotary switch
    left right
2021-04-21 step motor
2021-05-01 char lcd menu
    fix bug & add remocon, ultrasonic
    [GPIO_OUT.c]
2021-05-06 orcad
    lcd menu cad
    [AM32F103-V1.DSN, AM32F103-v1.opj, AM_MICOM_BASE-R2_0_4.DSN, PCB_AM_MICOM_BASE_R2_0_6.pcb, am_micom_base-r2_0_4.opj, uno_extension_1.pcb]
2021-05-14 new cad
    [AM32F103-V1.DSN, AM32F103-v1.opj, Uno_Led_Servo_Pwm.pcb, Uno_Led_Servo_Pwm_test_1.pcb, Uno_Led_Servo_Pwm_test_2.pcb, Uno_Led_Servo_Pwm_test_3.pcb, uno_extension_1.pcb]
2021-06-17 arm
    3d priter code
    [uno_extension_1.pcb]
